krishkc5/agrasic/agriasic_digital_v2/docs/interface_contract.md

# AgriASIC Digital Interface Contract

Refreshed for Rev 4.2 + Rev 4.3 Phases 1-6. This document describes the
**currently implemented** RTL only. It covers the SPI/parallel-programming/
RV32I-MMIO *register* interfaces, none of which changed in Phase 7 or 8 —
the 3-frequency-point sweep that Phase 7 added lives entirely inside RV32I
*firmware* (`fw/fw.c`), not in any new register or protocol behavior, so
nothing below needed updating for it. What Phase 7 did surface is an
architectural gap in how that firmware's results reach a host at all — see
the "GAP-11" note under "What is not in this contract yet" below, and
[`agriasic_digital_MAS.md`](agriasic_digital_MAS.md) section 10.3 for full
detail. Temperature sensing (Phase 7.3) remains unbuilt in any digital RTL.

The previous version of this document predated three SPI behavior changes and
the whole Phase 1-3 restructure; do not write host firmware from an older
copy. It also predates Phase 4's excitation rearchitecture — the "phase
change" / "polarity register" language is gone, replaced by a free-running
phase counter (see "Analog front-end interface" below) — Phase 5's I/Q
accumulation, which turned every "the result" singular below into two
independent channels (see "Measurement control" and the register map) — and
Phase 6's full register-map renumbering (see the register map below; **every
address after 0x2 has moved or changed meaning** compared to any document
predating this one).

## Port naming convention

Every port on a boundary module (`agriasic_digital_rv32i_top`,
`agriasic_digital_spi_top`, `agriasic_digital_programming_top`,
`agriasic_digital_top`, `agriasic_rv32i_control_shell`) carries a prefix
saying where the signal goes:

| Prefix | Meaning |
|---|---|
| `afe_` | Crosses into the **analog front end**. Die-internal, unless the AFE is off-chip in a test configuration. |
| `gpio_` | Leaves the die — **bond these**. |
| `dbg_` | **Observability only. Do not bond.** Exposed so testbenches, the power flow and the memory audit can watch internal state without hierarchical references. |
| *(none)* | **Die-internal block-to-block wiring**, plus `clk` and `rst_n`. The two clock/reset pins are real pads, but "GPIO" implies a general-purpose bidirectional cell, which they are not. |

The prefix classifies a signal by **where it ends up**, not by which module
declares it. So a boundary module still has unprefixed ports where they simply
connect it to another block on the same die — `agriasic_rv32i_control_shell`
drives the measurement engine through `cfg_*_o` / `result_*_o` / `busy_o` /
`done_o`, and `agriasic_digital_top` receives them through `cfg_*_i` and
`start`. None of those reach a pad or the AFE, so none of them take a prefix.
The same signals *do* take `dbg_` where a chip top re-exports them purely for
observability.

Leaf modules (`sar_controller`, `excitation_ctrl`,
`measurement_fsm`, `spi_slave`, `regfile`, `agriasic_spi_boot`) deliberately
keep unprefixed local names — the prefix marks a chip boundary, and would
mean nothing three levels down. So `sar_controller.mux_sel_o` connects to
`agriasic_digital_top.afe_mux_sel_o`, and both names are correct.

## Clock and Reset
- `clk`: single digital clock domain for the entire design. As of Phase 3,
  there is no second clock domain anywhere in the synthesizable RTL — SPI's
  `sclk_i` is oversampled, not run as its own clock (see below).
- `rst_n`: active-low, asynchronous assert. Each chip-boundary top
  (`agriasic_digital_spi_top`, `agriasic_digital_programming_top`,
  `agriasic_digital_rv32i_top`) synchronizes it internally with a 2FF reset
  synchronizer (`rst_sync.sv`) before distributing it — synchronous
  deassert, so every internal flop sees a clean release edge regardless of
  when the external pin actually released.

## Measurement control
Names below are the measurement engine's (`agriasic_digital_top`). At a chip
top the same signals appear as `gpio_start_i` (in) and `dbg_busy_o` /
`dbg_done_o` / `dbg_result_*` (out).

- `start` / `gpio_start_i`: one-cycle pulse to begin one measurement run
- `busy_o`: high while the FSM is executing the run
- `done_o`: pulses high for one core cycle when the run completes (the SPI
  wrapper latches this into a sticky `REG_STATUS` bit — see below — because a
  host polling over SPI cannot reliably catch a single-cycle pulse)

  > **`dbg_done_o` at `agriasic_digital_rv32i_top` is a different signal with
  > the same name shape, and the pulse semantics above do NOT apply to it.**
  > The control shell assigns `done_o = fw_done`
  > (`agriasic_rv32i_control_shell.sv`): a **sticky level**, raised when the
  > firmware writes `CTRL.FW_DONE` after the last sweep point, cleared only by
  > a core reset via `run_clear_i`. It means *the whole sweep is finished and
  > the DMEM result block is stable*, not *one measurement completed*.
  > `dbg_busy_o` is likewise `!core_rst && !fw_done` — program running, not
  > engine running. Reading this section as written and building edge
  > detection for a host would be wrong twice over: the signal is a level,
  > and per the MAS prefix table a `dbg_` port is testbench observability and
  > **never reaches a pad**. See "Completion signalling" under the host SPI
  > port for what a host actually uses.
- `result_dv_i_o` / `result_dv_q_o` / `result_cur_i_o` / `result_cur_q_o`,
  all `[15:0]` (Rev 5; these replaced the Rev 4.3 `result_i_o`/`result_q_o`
  pair, which in turn replaced a single `result_o`): the voltage and current
  channel accumulators, in-phase and quadrature, each
  independently signed and valid once `done_o` has pulsed. Both are **shadow
  registers** — they latch the internal accumulators' final value only on
  measurement completion, so a read mid-run always returns the *previous*
  run's result, never a partial sum in progress (see the register map below
  for how these are exposed over each host interface)

## Host SPI port (closes GAP-11, `agriasic_digital_rv32i_top`)

Four pads, **separate from the flash port** because the two run opposite
directions on every wire. The chip is the slave.

| Pin | Dir | Meaning |
|---|---|---|
| `gpio_spi_sclk_i` | in | Host-driven clock, mode 0. **Max f_clk/16**, as for the SPI-host variant: oversampled, not a real clock. |
| `gpio_spi_cs_n_i` | in | Active low. One transaction per assertion; releasing it resets the framing. |
| `gpio_spi_mosi_i` | in | Command, address and write data. |
| `gpio_spi_miso_o` | out | Read data and status. |
| `gpio_spi_miso_oe_o` | out | Output enable; high only while selected. |

Protocol, one transaction per CS_N assertion:

| Phase | Bytes | Content |
|---|---|---|
| command | 1 | `0x03` READ, `0x02` WRITE, `0x05` RDSR |
| address | 4 | 32-bit, **big endian** (MSB first) |
| data | n x 4 | **little endian** within each word, address auto-increments by 4 |

`RDSR` returns one status byte: `[0]` busy, `[1]` sticky error. The sticky bit
clears at the **end** of the status transaction, so the byte the host reads
still carries it.

**Reach:** DMEM and the peripheral window only. IMEM and the debug module are
refused by the interconnect and raise the sticky error. Writes commit whole
32-bit words; a transaction cut short mid-word commits nothing.

### Completion signalling — the host polls (decided 2026-10-28)

**The chip never initiates.** There is no interrupt line, no attention pin and
no done pad. A host learns that a sweep has finished by polling, and that is a
decision rather than an omission: promoting `dbg_done_o` to a real pin was
considered and declined. It would have taken the digital side to 19 pads to
save traffic that measures, at a 0.5 ms poll interval over a 29 ms sweep,
about 139 µs of SPI time — roughly 0.5 % bus duty, against a core that is
parked in `wfi` for nearly all of it. Bandwidth was never the argument.

**Poll `STATUS[6]` (`fw_done`), not `RDSR`.** The `RDSR` byte carries `[0]`
bridge busy and `[1]` sticky error — the bridge's own state, nothing about the
measurement. `fw_done` lives only in the MMIO word at `0x8000_0014`, so the
poll is a `0x03` READ:

```
CS_N ↓
  0x03                    READ
  0x80 0x00 0x00 0x14     address, big endian
  0x00                    one dummy byte; STATUS[7:0] streams back
CS_N ↑
→ done when (byte & 0x40)
```

Six bytes, not nine: data is little endian within a word, so `STATUS[7:0]` —
and with it bit 6 — arrives first, and dropping `CS_N` early ends the
transaction cleanly because a read commits nothing. Reading `STATUS` has no
side effects (`fw_done_q` clears only on reset, `run_clear_i` or a `CTRL`
write, never on a read, unlike the `RDSR` sticky bit), so the poll is
idempotent.

**Do not poll `STATUS[0]`.** That is the engine's per-measurement busy, which
returns to idle 16 times during one 8-point sweep, so a host watching it can
declare victory on a half-written result block. Bit 6 is the only flag with
whole-sweep meaning.

This one deserves emphasis because it does **not** fail loudly. Scenario E
counts the polls that catch the engine idle mid-sweep and measured **0 of 90**
at a 0.5 ms interval: the gaps between measurements are microseconds wide
against a millisecond poll, so a host polling bit 0 passes on the bench and
then fails intermittently in the field, at a rate that depends on nothing but
poll phasing. A bit that is wrong 1 % of the time is harder to find than one
that is wrong always.

For the same reason, do not poll a DMEM word either — `OUT_NUM_POINTS`
is written last and is tempting, but DMEM is a latch array with undefined
power-up content, so no value distinguishes "not written yet".

**Why the flag can be trusted.** Every result store precedes the
`CTRL.FW_DONE` store in program order, and Ibex's LSU is strictly in-order
with one outstanding request — there is no store buffer that could let the
MMIO write retire ahead of the DMEM writes. Waiting for bit 6 is also what
prevents a **torn read**: the bus arbitrates per word, so a burst taken
mid-sweep can mix one point's `OUT_DV_I` with the previous sweep's
`OUT_DV_Q`. Nothing in the chip prevents that, by design — the host SPI port
is deliberately allowed to read DMEM while the core runs.

**Host-side timeout.** Size it for the worst configuration, not the measured
one. Sweep duration is
`cycles ≈ 16 · ΣN · measurements · (settle + 2·2^pair_log2)`, which is 4.68 M
cycles (29 ms at 160 MHz) at the firmware's defaults but 60.8 M (**380 ms**) at
`pair_log2 = 6`. `tb_agriasic_spi_host.sv` scenario E derives its bound from
this formula rather than hard-coding one, and runs exactly the poll sequence
above.

**Re-arming** is a `gpio_start_i` pulse: that resets the core, which clears
`fw_done` through `run_clear_i` in the same event, so there is no stale-done
race on a second sweep. A host cannot re-trigger the firmware over SPI — M4
is denied the debug module, and the firmware parks in `wfi` after one sweep.

---

## Analog front-end interface (Rev 4.3 Phases 1 and 4) — SUPERSEDED

> **Superseded by "Analog front-end interface (Rev 5, tetrapolar)" below.**
> Kept for the `adc_comp_i` convention and the SAR timing discussion, which
> still hold. Two things here are out of date: `exc_drive_p_o`/`exc_drive_n_o`
> no longer exist (Rev 5 replaced the square-wave pair with a sine DAC code),
> and every port named below now carries the `afe_` prefix at a boundary
> module — `adc_sample_o` is `afe_sample_o`, the rest are `afe_<name>`.

`adc_code_i` no longer exists anywhere in this design. The digital side now
runs the SAR bit-trial search itself:

| Port | Direction | Purpose |
|---|---|---|
| `exc_drive_p_o` | out | Positive excitation drive |
| `exc_drive_n_o` | out | Negative excitation drive |
| `adc_enable_o` | out | Analog core enable, asserted for the full conversion |
| `adc_sample_o` | out | Track-and-hold strobe, one cycle at conversion start |
| `adc_dac_o[7:0]` | out | Bit-trial DAC code, MSB-first successive approximation |
| `adc_comp_i` | in | Comparator decision (see convention below) |

**Excitation drive (Phase 4: free-running, no command input).** Excitation is
generated by a free-running divider and 4-bit phase counter — there is no
longer a "phase change" event to break before making: `exc_drive_p_o` and
`exc_drive_n_o` are pure combinational functions of the current phase value.
Phase encoding is 0-6 drive positive, 7 dead, 8-14 drive negative, 15 dead —
7 states per polarity half, exactly equal, with exactly one dead state
between every transition. `{exc_drive_p_o, exc_drive_n_o} = 2'b11` remains
structurally unreachable: the two drive signals are mutually exclusive
combinational ranges of the same phase counter, so no phase value can satisfy
both. The old `DEAD_CYCLES` RTL parameter is gone; dead time is now just
"one reserved phase state" (index 7 or 15), lasting exactly `N` clock cycles
(one phase state's duration) at both lines low before the next polarity
starts — and whether that is enough real dead time is still an open question
pending a number from analog (see the MAS, GAP-6).

Excitation frequency follows `f_exc = f_clk / (16 x N)`, verified exact (not
approximate) in simulation. As of Phase 6, N is set indirectly over SPI via
`REG_FREQ_SEL` (see the register map below), not written directly.

**`adc_comp_i` convention.** `1` = input ≥ current trial code (keep the bit,
it's a valid lower bound); `0` = input < current trial code (clear the bit,
it overshot). This is a **timed, unsynchronized** path — the controller
holds each trial code for at least `REG_CONV + 3` clk cycles before sampling the
decision (`S_TRIAL_SET`, `REG_CONV + 1` cycles of `S_TRIAL_WAIT`,
`S_TRIAL_EVAL`; see the register map). The code comes straight from a
register and changes once per trial, so it is glitch-free for that whole
window. Do not add a synchronizer to this signal; that would defeat the
point of a timed interface.

## SPI protocol
- Mode: SPI mode-0 (`CPOL=0`, `CPHA=0`)
- **Max SCLK = f_clk/16.** This is load-bearing, not a suggestion: `gpio_spi_sclk_i`,
  `gpio_spi_cs_n_i` and `gpio_spi_mosi_i` are 2FF-oversampled into the `clk` domain (Rev 4.3
  Phase 3), and the synchronizers need this much margin to resolve edges
  reliably. Exceeding it corrupts data — verified directly by
  `tb_spi_domain_crossing.sv`, which shows correct operation at exactly this
  rate and demonstrated corruption below the sampling clock's own Nyquist
  rate.
- `gpio_spi_miso_o` changes on a **synchronized** SCLK falling edge (an edge detected
  on the oversampled signal, not a real clock edge — there is no `gpio_spi_sclk_i`
  clock domain to speak of anymore)
- `gpio_spi_miso_oe_o`: high only while `gpio_spi_cs_n_i` is selected (synchronized), so
  pad-level logic can put `MISO` in high-Z otherwise. Combinationally derived
  from the synchronized `cs_n`, so it changes the same cycle selection does.
- Command byte format:
	- `bit[7]`: `1=READ`, `0=WRITE`
	- `bit[6:3]`: 4-bit register address
	- `bit[2:0]`: reserved, must be `3'b000`
- Every transaction is 2 bytes (`Byte0=command`, `Byte1=data/dummy`)
- If `Byte0` is illegal (reserved bits or bad address), the wrapper consumes
  `Byte1` and discards it to keep framing aligned
- **`gpio_spi_cs_n_i` deasserted mid-byte** resets only the SPI framing state (bit
  counter, TX shift register) — never any measurement state, which
  `spi_slave` has no access to in the first place. Reselecting starts a clean
  new byte; no chip reset is needed to recover from an aborted transaction.
- **No mandatory inter-byte gap.** An earlier revision of this document (and
  an earlier design revision) required leaving a gap of a few core clocks
  between bytes so a freshly decoded response byte had time to settle before
  being shifted out. As of Phase 3 this is no longer a separate requirement:
  the response byte is ready one `clk` cycle after the command byte
  completes, and at `f_clk/16` even a fully back-to-back byte leaves at least
  8 `clk` cycles of margin before the next possible falling edge. The
  `f_clk/16` rate limit already covers it.

The `spi_slave` leaf module inside `agriasic_digital_spi_top` keeps its own
unprefixed `sclk_i`/`cs_n_i`/`mosi_i`/`miso_o`/`miso_oe_o` port names; the
`gpio_spi_` names above are the chip pins those connect to.

## SPI response codes
- `0xA5`: write accepted (ACK)
- `0x5A`: write rejected (NACK, e.g. write to read-only register)
- `0xE1`: invalid command (`cmd[2:0] != 0`)
- `0xE2`: invalid register address

## Register map (as implemented, Rev 4.3 Phase 6)

This is now the Rev 4.3 **target** register layout, not an interim one — see
the two exceptions called out after the table.

| Addr | Name | Access | Purpose |
|---|---|---|---|
| `0x0` | `REG_CTRL` | RW | bit[0] write-one pulse to start measurement; bit[7] write-one clears sticky protocol error bits in `REG_STATUS[7:5]`. **No core-enable bit** — see the note below |
| `0x1` | `REG_PAIR_LOG2` | RW | Pair count as log2 (`M = 2^REG_PAIR_LOG2`). Values above 6 are clamped to 64 in hardware and set `REG_STATUS` bit[4] (overrange) |
| `0x2` | `REG_SETTLE` | RW | Excitation *periods* to wait after `start` before the FSM begins watching for a phase match (not raw clock cycles) |
| `0x3` | `REG_FREQ_SEL` | RW | **2-bit selector, not raw N**: `0` -> 10 MHz (N=1), `1` -> 100 kHz (N=100), `2` -> 1 kHz (N=10000). Replaces the Phase 1-5 `REG_DIVIDER` on *this* interface only. **It reaches 3 of the firmware's 8 sweep points and does not define the sweep** — see the note below |
| `0x4` | `REG_PHASE_IDX` | RW | Present in the map; writes are stored and read back, but **not wired to anything** — see the note below |
| `0x5` | `REG_CONV` | RW | Comparator regeneration wait, **in clk cycles, per SAR bit trial** — not total conversion latency. Total conversion time is `8 x (3 + REG_CONV)` clk cycles. Runtime-tunable because the real regeneration time isn't characterized yet |
| `0x6` | `REG_STATUS` | RO | bit[7] sticky protocol error; bit[6] sticky bad address; bit[5] sticky illegal write to RO register; bit[4] **overrange** (new); bit[1] done — **sticky**, latched when the FSM's one-cycle `done_o` fires, held until the next start; bit[0] busy |
| `0x7` | `REG_RESULT_IDX` | RW | Pointer into the result byte vector, 0-15. **Auto-increments only on a `REG_RESULT_DATA` read** — not on writes to this register, and not on reads of this register itself |
| `0x8` | `REG_RESULT_DATA` | RO | Byte at the current index — see the mapping below |
| `0x9` | `REG_ID` | RO | Fixed design/revision identifier, `0x43` |

**`REG_RESULT_DATA` index mapping.** This 16-byte indexed window belongs to
the legacy 2-byte SPI interface and was specified when the target was I/Q at
three frequency points plus temperature (13 bytes). **It is superseded for
sweep results**: the firmware now sweeps eight points with four results each
(dV I/Q and current I/Q) = 128 bytes, which this window cannot express. Read
sweep results from DMEM over the host SPI port or JTAG instead — the map is at
the end of this section. The window below remains accurate for what it is: a
single live I/Q pair from the measurement engine's shadow registers.

```text
idx 0: I low byte      idx 1: I high byte
idx 2: Q low byte      idx 3: Q high byte
idx 4-15: reserved, reads as 0x00 (future frequency points + temperature)
```

Read index 0-3 in order after setting `REG_RESULT_IDX = 0` to get a full I/Q
readout in 4 back-to-back reads with no further index writes needed — the
pointer auto-increments. Indices 4-15 read as a deliberate zero, not garbage:
no per-point result vector was ever built behind this window, and none will be
— the firmware's DMEM result block replaced the idea.

**Result semantics (Rev 4.3 defect fix D-3, unchanged since Phase 1):** each
channel is `sum(D+ - D-)` over M pairs — the **raw** accumulated difference,
with no per-pair scaling applied on die. Divide by M yourself, and by 2 again
for the true chop average: `I = (D(0°) - D(180°))/2`, `Q = (D(90°) -
D(270°))/2`. Both channels are **shadow registers**, not live accumulators —
they latch only when a run completes, so a host that reads mid-run (which it
should not do — check `busy_o`/`REG_STATUS` bit[0] first) gets the previous
run's complete result, never a partial sum.

**`REG_FREQ_SEL` — why a selector, and what it is NOT.** Read this before
assuming the chip only does three frequencies: **it does eight.** The sweep is
driven by firmware writing raw N to the MMIO `REG_DIVIDER` (14 bits, N =
1..16383, f_exc = 10 MHz / N), and `fw.c`'s `sweep_divider()` walks N = 1, 10,
32, 100, 316, 1000, 3162, 10000 — a half-decade log ladder from 10 MHz to
1 kHz. `REG_FREQ_SEL` is a convenience on the *legacy 2-byte SPI and parallel
programming* interfaces, which cannot carry 14 bits in one byte; it exposes
three of those eight N values as presets. Changing the sweep means editing
`sweep_divider()`, not this register.

The reason it is a selector at all: the internal divider is 14 bits (needs
N=10000 for the 1 kHz point) — too wide for a single SPI byte to carry, and
the 2-byte SPI protocol isn't being widened to fit it. A selector
is the only encoding that reaches 1 kHz through one SPI byte: the host writes
0/1/2, the wrapper looks up the matching N combinationally, and
`excitation_ctrl` never sees the difference. The parallel programming
interface uses the identical selector (`CFG_FREQ_SEL`) for the same reason.
**RV32I MMIO keeps a separate, differently-named register, `REG_DIVIDER`,
taking raw N directly** (word offset `0x8000_000C`) — native 32-bit MMIO
writes have no byte-framing constraint, so there was nothing to work around,
and giving it the same name as SPI's selector-based register would wrongly
suggest matching semantics.

**Two reserved items with no implemented semantics — `REG_PHASE_IDX` and
`REG_CTRL`'s core-enable bit.** Both are called for by the baseline design
doc's register map, and both accept writes and read them back, but do
nothing:
- `REG_PHASE_IDX` ("phase index into the 16-state counter") doesn't reconcile
  with how I/Q sampling actually works: `measurement_fsm` watches four FIXED,
  90-degree-spaced phase points, not one selectable one. A plausible reading
  — a phase offset shifting all four points together, as a calibration trim
  — is an interpretation, not a specification; building RTL against a guess
  for a silicon-bound register was judged worse than an honest no-op.
- `REG_CTRL`'s core-enable bit presumes a unified chip with a toggleable
  on-die RV32I core, which doesn't exist: the RV32I and SPI control paths are
  two separate, mutually exclusive top-level modules today
  (`agriasic_digital_rv32i_top` vs. `agriasic_digital_spi_top`).

Do not write host firmware that depends on either of these until the MAS's
GAP-10 is resolved with the people who specified them.

**Same result semantics, different mechanisms, on every host interface.** The
parallel programming interface (`agriasic_digital_programming_top`) exposes
both channels as bare `result_i_o`/`result_q_o` output ports — no index
scheme, since a direct hardware interface has no byte-framing reason to need
one. The RV32I MMIO interface exposes `REG_RESULT_I` at word offset
`0x8000_0018` and `REG_RESULT_Q` at `0x8000_001C` directly (see `fw/fw.c`).

## What is not in this contract yet
The register map above is the Rev 4.3 target layout as far as *mechanisms*
go. What's still missing is the *data* behind some of it:
- Real I/Q data for frequency points 2 and 3, and temperature, **on the SPI/
  parallel-programming/RV32I-MMIO register interfaces described above** —
  `REG_RESULT_DATA` indices 4-12 still read as zero on those interfaces. The
  3-frequency-point sweep itself now exists (Phase 7), but only as RV32I
  *firmware* logic (`fw/fw.c`) writing to its own scratch RAM, not as new
  register/protocol behavior on any of the interfaces this document covers
- `REG_PHASE_IDX` and `REG_CTRL`'s core-enable bit's actual semantics (see
  the notes above and MAS GAP-10)

**GAP-11 is resolved — sweep results ARE readable off chip.** This paragraph
previously said they were not; that predated the host SPI port.
`agriasic_digital_rv32i_top` now carries a host SPI slave port
(`agriasic_spi_host.sv`, bus master M4) that reaches DMEM and the peripheral
window with 32-bit accesses while the core runs, and the debug SBA reaches the
same memory over JTAG. Both paths are covered by the regression (stage 15
reads `OUT_COUNT`, `OUT_NUM_POINTS` and per-point results over SPI; stage 13
does the same over SBA).

### Sweep result map (DMEM, read over host SPI or JTAG SBA)

DMEM base is `0x0001_0000` and the result block starts at offset 0. Each array
is **8 words (0x20) wide** — one word per sweep point, indexed by point 0..7 in
the order `sweep_divider()` produces them (10 MHz first, 1 kHz last).

| Offset | Name | Words | Contents |
|---|---|---|---|
| `0x000` | `OUT_COUNT` | 1 | measurements averaged per point (2) |
| `0x004` | `OUT_NUM_POINTS` | 1 | points actually completed; **< 8 means the sweep was aborted** |
| `0x008` | `OUT_TEMP` | 1 | sentinel `-1`, not implemented (GAP-11 temperature half) |
| `0x00C` | reserved | 5 | reads undefined; do not rely on it |
| `0x020` | `OUT_DIV[8]` | 8 | divider N used at each point |
| `0x040` | `OUT_DV_I[8]` | 8 | dV in-phase average |
| `0x060` | `OUT_DV_Q[8]` | 8 | dV quadrature average |
| `0x080` | `OUT_CUR_I[8]` | 8 | current in-phase average |
| `0x0A0` | `OUT_CUR_Q[8]` | 8 | current quadrature average |
| `0x0C0` | `OUT_AFE[8]` | 8 | `AFE_CTRL` value and overrange flags per point |
| `0x0E0` | — | 28 | guard, then the stack grows down from `0x180` |

Read `OUT_NUM_POINTS` first and trust only that many entries of each array: an
aborted sweep leaves the remaining entries holding the previous run's values,
not zeros. Results are valid once `STATUS.FW_DONE` is set; the same raw
accumulator semantics apply as above (divide by `OUT_COUNT`, and by 2 again
for the true chop average).

The map lives in one place, the header comment of `fw/fw.c`. If these offsets
and that comment ever disagree, the firmware is right and this table is stale.

---

## JTAG debug port (Phase 2, `agriasic_digital_rv32i_top` only)

Five pins, IEEE 1149.1, into the RISC-V debug module (pulp `riscv-dbg`,
Debug Spec 0.13) inside the control shell. Present only on the RV32I chip
variant; `agriasic_digital_spi_top` is unchanged.

| Pin | Dir | Notes |
|---|---|---|
| `gpio_jtag_tck_i` | in | Test clock. Keep well below the core clock (the DTM crosses TCK -> clk with a 2-phase handshake); 1 MHz is safe for any core clock above ~10 MHz. |
| `gpio_jtag_tms_i` | in | Test mode select. Five cycles high resets the TAP without TRST. |
| `gpio_jtag_trst_ni` | in | Asynchronous TAP reset, active low. Independent of `rst_n`, so a debugger can stay attached across a chip reset. Tie high if unused. |
| `gpio_jtag_tdi_i` | in | Data in, sampled on rising TCK. |
| `gpio_jtag_tdo_o` | out | Data out, launched on falling TCK. Not tri-stated (single device on the chain). |

IDCODE `0x14341001` (version 1, part `0x4341`). IR length 5: `0x01` IDCODE,
`0x10` DTMCS, `0x11` DMI (abits = 7). DM base `0x1A11_0000`; halt / resume /
exception entries at `+0x800 / +0x808 / +0x810`.

Debugger-visible address map: IMEM `0x0000_0000` (1 KiB, writable: `load`
works), DMEM `0x0001_0000` (384 B, 96 words), DM `0x1A11_0000`, MMIO `0x8000_0000`
(register map in section 7.1 / `agriasic_rv32i_mmio.sv`). Any other address
is a bus error. `dmcontrol.ndmreset` resets the core and the MMIO bridge
(config registers, sticky flags) but not IMEM, the DM or the TAP.

The hart is held in reset and reported `unavailable` to the debugger while
`gpio_start_i` is low. `fw/openocd_agriasic.cfg` is the reference OpenOCD target
file.

---

## SPI-flash boot port (Phase 3, `agriasic_digital_rv32i_top` only)

| Pin | Dir | Notes |
|---|---|---|
| `gpio_boot_sel_i` | in | Strap, sampled once on the first cycle out of reset. **0 (default): shadow-load the on-die golden boot ROM into IMEM** -- no flash needed. 1: load from external SPI flash instead. `BOOT_CTRL` overrides either way. |
| `gpio_flash_sck_o` | out | SPI mode 0 clock, clk/16 during boot (10 MHz at 160 MHz); firmware-selectable afterwards. |
| `gpio_flash_cs_n_o` | out | Active-low chip select. |
| `gpio_flash_mosi_o` | out | Master out. |
| `gpio_flash_miso_i` | in | Master in. |
| `gpio_boot_fail_o` | out | High when the boot FSM ended in FAIL (also `BOOT_STATUS[10]`). |

Flash image at address 0, little-endian words: `0x41475241` ("AGRA"),
payload length (bytes, multiple of 4, <= 4096), version, CRC-32 (zlib) of the
payload; then the payload. Produced by `fw/build.sh` as
`agriasic_fw_flash.bin`. Only `READ 0x03` is used; any 3-byte-address SPI NOR
works. The loader waits `BOOT_DELAY_CYCLES` (default 800k = 5 ms) after reset
for the flash's power-up time.

Registers (data-port / SBA window `0x8000_0020..0x8000_003F`):

| Address | Name | Access | Bits |
|---|---|---|---|
| `0x8000_0020` | `BOOT_STATUS` | R | [3:0] state (7 DONE, 8 FAIL, 9 SKIP, 10 ROM copy), [6:4] error (1 magic, 2 length, 3 CRC, 4 bus; a ROM boot can only report 4), [8] fw_valid, [9] latched strap, [10] boot_fail, [11] busy, [13:12] source (0 none/skip, 1 golden ROM, 2 flash), [31:16] image version (flash header; 0 for a ROM boot) |
| `0x8000_0024` | `BOOT_CTRL` | W | [0] release core, [1] re-boot from flash, [2] re-boot from the golden ROM (each drops fw_valid first: core reset, then reboot) |
| `0x8000_0028` | `SPI_CTRL` | RW | [0] cs_n, [15:8] clock divider (SCK = clk / 2(div+1)) |
| `0x8000_002C` | `SPI_DATA` | RW | W: byte to send (starts a transfer); R: last byte received |
| `0x8000_0030` | `SPI_STATUS` | R | [0] busy, [1] firmware owns the SPI pins (boot FSM idle) |

---

## Analog front-end interface (Rev 5, tetrapolar)

Digital-to-analog signals. The first seven are present on all three chip tops
(`agriasic_digital_rv32i_top`, `agriasic_digital_spi_top`,
`agriasic_digital_programming_top`). **`afe_tia_rf_o` is RV32I-only** --- the
legacy 2-byte SPI and parallel-programming register maps have no `AFE_CTRL`
register to set it from, so on those variants the TIA gain is not controllable
at all. These are die-internal to the AFE, not pads, except where the AFE is
off-chip in a test configuration.

| Signal | Dir | Meaning |
|---|---|---|
| `afe_sine_code_o[7:0]` | out | Sine DAC code, offset binary, mid-code 128 = VCM (0.9 V). 16-point cosine, one code per phase state. Registered and glitch-free: changes only on a phase step, or one cycle after the excitation is enabled, disabled or its amplitude changes. |
| `afe_mux_sel_o[1:0]` | out | Analog mux: 0 = dV (differential PGA on E2/E3), 1 = return current (TIA on E4). Stable for the whole conversion. |
| `afe_sample_o` | out | Track-and-hold strobe. Fires ONCE per phase point and freezes **both** channels' S/H simultaneously. |
| `afe_adc_enable_o` | out | High for the duration of each conversion (comparator bias/power gate). |
| `afe_adc_dac_o[7:0]` | out | SAR trial code to the ADC's internal DAC. Registered: changes once per trial and is then stable for at least `REG_CONV + 3` clk cycles. |
| `afe_adc_comp_i` | in | One comparator decision: 1 = input >= trial code. Timed, unsynchronized — `REG_CONV` must cover regeneration at the worst corner. |
| `afe_conv_start_o` | out | One-cycle pulse marking the start of each conversion, issued **after** the `mux_settle` wait rather than at request acceptance, so it lands once the mux and S/H have settled onto the ADC input. One per conversion, so two per `afe_sample_o` strobe. |
| `afe_tia_rf_o[2:0]` | out | TIA feedback resistor: **three switch wires**, same decode. **RV32I top only** --- see the note above. |

**The differential PGA has a FIXED gain** and no digital control. In a
voltage-driven tetrapolar measurement dV is a fixed fraction of the drive set by
electrode geometry, so that channel has little dynamic range; the current channel
carries it. `AFE_CTRL[1:0]` is reserved, reads 0.

**Gain encoding.** The TIA control is a 2-bit code in `AFE_CTRL` decoded to three
switch wires by `gain_decode` in `agriasic_rv32i_mmio.sv`, so the analog side
needs no decoder and illegal switch combinations are unreachable. The register
reads back the **code**, not the wires. Current mapping, *pending analog
confirmation* -- that function is the only place to change it:

| Code | Wires | Meaning |
|---|---|---|
| 0 | `001` | switch 0 alone |
| 1 | `010` | switch 1 alone |
| 2 | `100` | switch 2 alone |
| 3 | `111` | all three in parallel |

No code leaves a network fully open. That is deliberate: for the TIA an open
feedback network has no DC path and the output rails, and the reset code is 0,
so an encoding where 0 meant "all switches open" would make railing the
power-on condition.

Per sample point the sequence is: strobe both S/H at the target phase ->
`mux_sel = 0`, wait `AFE_CTRL.mux_settle`, 8 bit trials -> `mux_sel = 1`,
wait, 8 bit trials. Four phase points (0/90/180/270 deg) make one
accumulation pair, so a pair is eight conversions.

Accumulators (all signed 16-bit, host-visible only via the shadow snapshot
taken when `busy` falls):

    dv_i  = sum( dV(0deg)  - dV(180deg) )      cur_i = sum( I(0deg)  - I(180deg) )
    dv_q  = sum( dV(90deg) - dV(270deg) )      cur_q = sum( I(90deg) - I(270deg) )

Impedance is computed off-die: Z(f) = (dv_i + j*dv_q) / (cur_i + j*cur_q).

**Simultaneous sample-and-hold is confirmed, not an assumption.** This
paragraph previously listed it as an open analog decision. The ADC progress
report of 2026-10-26 (Q4) states that two matched S/H schematics share
sampling phases and capture together, which is what the RTL has always
assumed; skew and mismatch between them are characterized but not yet
verified over corners. The alternative that was under consideration —
measuring dV on one excitation period and I on the next — is dropped: it
needs one fewer S/H but doubles the measurement time and assumes
stationarity across adjacent periods.

**The SAR bit trials stay in digital.** Confirmed with the ADC owner on
2026-10-27. The behavioural model shipped alongside that report
(`agrasic_adc_behavioral.sv`, a complete converter with an
`enable`/`capture`/`start`/`code`/`done` interface) is a **simulation aid
only** and is not the integration contract — its own README says it "does
not replace the final SAR controller." The boundary is therefore the one
in the table above and nowhere else: digital drives `afe_adc_dac_o` and reads
one `afe_adc_comp_i` decision per trial, and no `afe_adc_code_i` or
`afe_adc_done_i` port is being added. Two items on the analog side are still
open and would each cost a handful of gates if they land on digital: a
per-trial DAC / reference-switch enable, because the report's Q7 measures
settling from reference-switch enable rather than from the code edge, and the
binary-to-one-hot mux decode that its Q3 calls "external".

The golden ROM image is generated from `fw/golden/agriasic_fw_golden.hex` by
`fw/gen_boot_rom.py` into `rtl/rv32i/agriasic_boot_rom.sv`. It is frozen at
tapeout; the flash path is how a newer image is run. Both load into the same
IMEM SRAM at address 0, so firmware is linked once for both.
