krishkc5/agrasic/agriasic_digital_v2/docs/agriasic_highlevel.jpeg

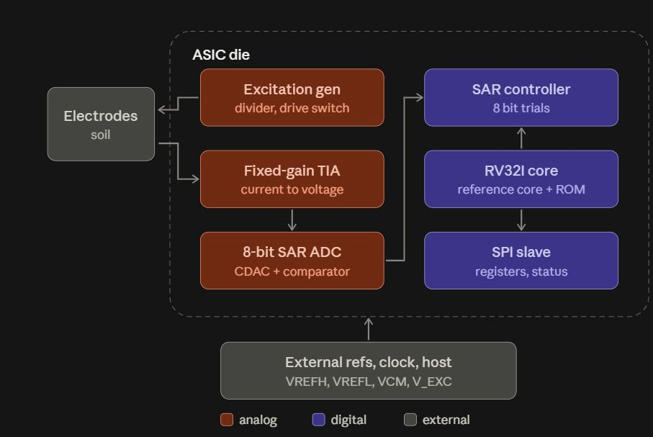
agriasic_digital_v2/docs/agriasic_highlevel.jpeg
