krishkc5/agrasic/agriasic_digital_v2/power/results/power_summary.pdf

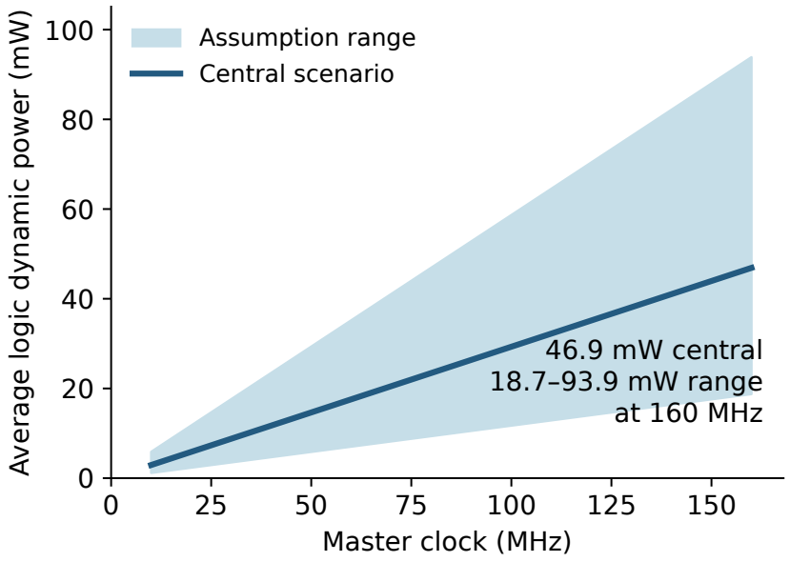
[picture p4: figure]
Master clock (MHz); Average logic dynamic power (mW); 46.9 mW central 18.7–93.9 mW range at 160 MHz; Assumption range Central scenario

0.0 | 2.5 | 5.0 | 7.5 | 10.0 12.5 15.0 17.5
Clock-related dynamic power (mW)

CPU pipeline

Register file

Mul/div

Measurement

Shell / MMIO / bus

Debug module

Boot loader

11.64

12.86

0.97

1.87

1.14

13.94

4.43

2,800 synthesized register bits
25 fF effective clock load per bit (assumed)

### Central assumption at 160 MHz

### Same firmware sweep, scaled clock

## AgriASIC digital power budget | 1.8 V

RTL activity + generic synthesis + assumed capacitances. Excludes memory macros, leakage and pads. 160 MHz is a target, not timing-verified. Range is a sensitivity study, not a confidence interval.
