krishkc5/agrasic/agriasic_digital_v2/memory/results/accesses.csv

cycle | after_ecall | kind | address | byte_mask
7 | 0 | fetch | 00000080 | f
8 | 0 | fetch | 00000084 | f
9 | 0 | fetch | 00000088 | f
10 | 0 | retire | 00000080 | f
10 | 0 | fetch | 0000008c | f
11 | 0 | retire | 00000084 | f
11 | 0 | fetch | 00000090 | f
11 | 0 | sp | 00010000 | 0
28 | 0 | sp | 00000000 | 0
30 | 0 | fetch | 00000080 | f
31 | 0 | fetch | 00000084 | f
32 | 0 | fetch | 00000088 | f
33 | 0 | retire | 00000080 | f
33 | 0 | fetch | 0000008c | f
34 | 0 | retire | 00000084 | f
34 | 0 | fetch | 00000090 | f
34 | 0 | sp | 00010000 | 0
35 | 0 | retire | 00000088 | f
35 | 0 | fetch | 00000094 | f
35 | 0 | sp | 00010200 | 0
36 | 0 | retire | 0000008a | f
38 | 0 | fetch | 00000148 | f
39 | 0 | retire | 0000008e | f
39 | 0 | fetch | 0000014c | f
40 | 0 | fetch | 00000150 | f
41 | 0 | retire | 00000148 | f
41 | 0 | fetch | 00000154 | f
41 | 0 | store | 000101fc | f
42 | 0 | retire | 0000014a | f
42 | 0 | store | 000101f8 | f
42 | 0 | sp | 000101e0 | 0
43 | 0 | retire | 0000014c | f
43 | 0 | fetch | 00000158 | f
43 | 0 | store | 000101f4 | f
44 | 0 | retire | 0000014e | f
44 | 0 | fetch | 0000015c | f
45 | 0 | retire | 00000150 | f
45 | 0 | fetch | 00000160 | f
46 | 0 | retire | 00000154 | f
46 | 0 | store | 80000000 | f
47 | 0 | retire | 00000158 | f
47 | 0 | fetch | 00000164 | f
48 | 0 | retire | 0000015a | f
48 | 0 | store | 80000004 | f
49 | 0 | retire | 0000015c | f
49 | 0 | fetch | 00000168 | f
50 | 0 | retire | 0000015e | f
50 | 0 | fetch | 0000016c | f
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
3155064 | 1 | retire | 0000009c | f
3155064 | 1 | fetch | 000000a8 | f
3155068 | 1 | fetch | 0000009c | f
3155069 | 1 | retire | 000000a0 | f
3155069 | 1 | fetch | 000000a0 | f
3155070 | 1 | fetch | 000000a4 | f
3155071 | 1 | retire | 0000009c | f
3155071 | 1 | fetch | 000000a8 | f
