krishkc5/agrasic/agriasic_digital_v2/power/results/activity.csv

row | cycles | imem_ce | ram_ce | periph_writes | adc_samples | adc_on | exc_on | done | pc_bit_toggles | divider_bit_toggles | core_enabled | core_reset
0 | 296 | 104 | 16 | 9 | 0 | 0 | 4 | 0 | 213 | 305 | 296 | 0
1 | 2778 | 0 | 0 | 0 | 32 | 2240 | 2764 | 2 | 3 | 0 | 0 | 10
2 | 259 | 76 | 14 | 3 | 0 | 0 | 4 | 0 | 168 | 304 | 259 | 0
3 | 31350 | 0 | 0 | 0 | 32 | 2240 | 31348 | 2 | 0 | 0 | 0 | 0
4 | 273 | 85 | 19 | 3 | 0 | 0 | 4 | 0 | 182 | 304 | 273 | 0
5 | 3120150 | 0 | 0 | 0 | 32 | 2240 | 3120148 | 2 | 0 | 0 | 0 | 0
6 | 4102 | 2344 | 0 | 0 | 0 | 0 | 0 | 0 | 5860 | 0 | 4102 | 0
7 | 4096 | 1 | 0 | 0 | 0 | 0 | 0 | 0 | 3 | 11 | 1 | 4095
