krishkc5/agrasic/agriasic_digital_v2/power/results/epochs.csv

time_ps | cycle | epoch | divider
10 | 1 | 2 | 0
70 | 7 | 1 | 0
220 | 12 | 2 | 0
280 | 18 | 1 | 0
680 | 58 | 2 | 1
14510 | 1441 | 1 | 1
14730 | 1463 | 2 | 1
28560 | 2846 | 1 | 1
30630 | 3053 | 2 | 100
187380 | 18728 | 1 | 100
187600 | 18750 | 2 | 100
344350 | 34425 | 1 | 100
346440 | 34634 | 2 | 10000
15947190 | 1594709 | 1 | 10000
15947410 | 1594731 | 2 | 10000
31548160 | 3154806 | 1 | 10000
31550340 | 3155024 | 3 | 10000
31591360 | 3159126 | 4 | 10000
