krishkc5/agrasic/agriasic_digital_v2/power/results/register_activity.csv

epoch | block | register_bits | bit_toggles | rising_transitions
1 | boot_loader | 347 | 35 | 16
1 | core_divider | 75 | 1056 | 533
1 | core_pipeline | 898 | 18094 | 9073
1 | core_register_file | 992 | 539 | 285
1 | debug_module | 1076 | 229 | 119
1 | measurement_engine | 235 | 99 | 18
1 | shell_mmio_reset | 103 | 730 | 370
2 | boot_loader | 347 | 12 | 10
2 | core_divider | 75 | 0 | 0
2 | core_pipeline | 898 | 2 | 2
2 | core_register_file | 992 | 0 | 0
2 | debug_module | 1076 | 32 | 26
2 | measurement_engine | 235 | 6330742 | 3165426
2 | shell_mmio_reset | 103 | 20 | 12
3 | boot_loader | 347 | 0 | 0
3 | core_divider | 75 | 0 | 0
3 | core_pipeline | 898 | 112510 | 56268
3 | core_register_file | 992 | 0 | 0
3 | debug_module | 1076 | 2344 | 1172
3 | measurement_engine | 235 | 0 | 0
3 | shell_mmio_reset | 103 | 2345 | 1172
4 | boot_loader | 347 | 0 | 0
4 | core_divider | 75 | 10 | 0
4 | core_pipeline | 898 | 53 | 20
4 | core_register_file | 992 | 31 | 0
4 | debug_module | 1076 | 2 | 1
4 | measurement_engine | 235 | 0 | 0
4 | shell_mmio_reset | 103 | 4 | 1
