krishkc5/agrasic/agriasic_digital_v2/power/results/power_summary.png

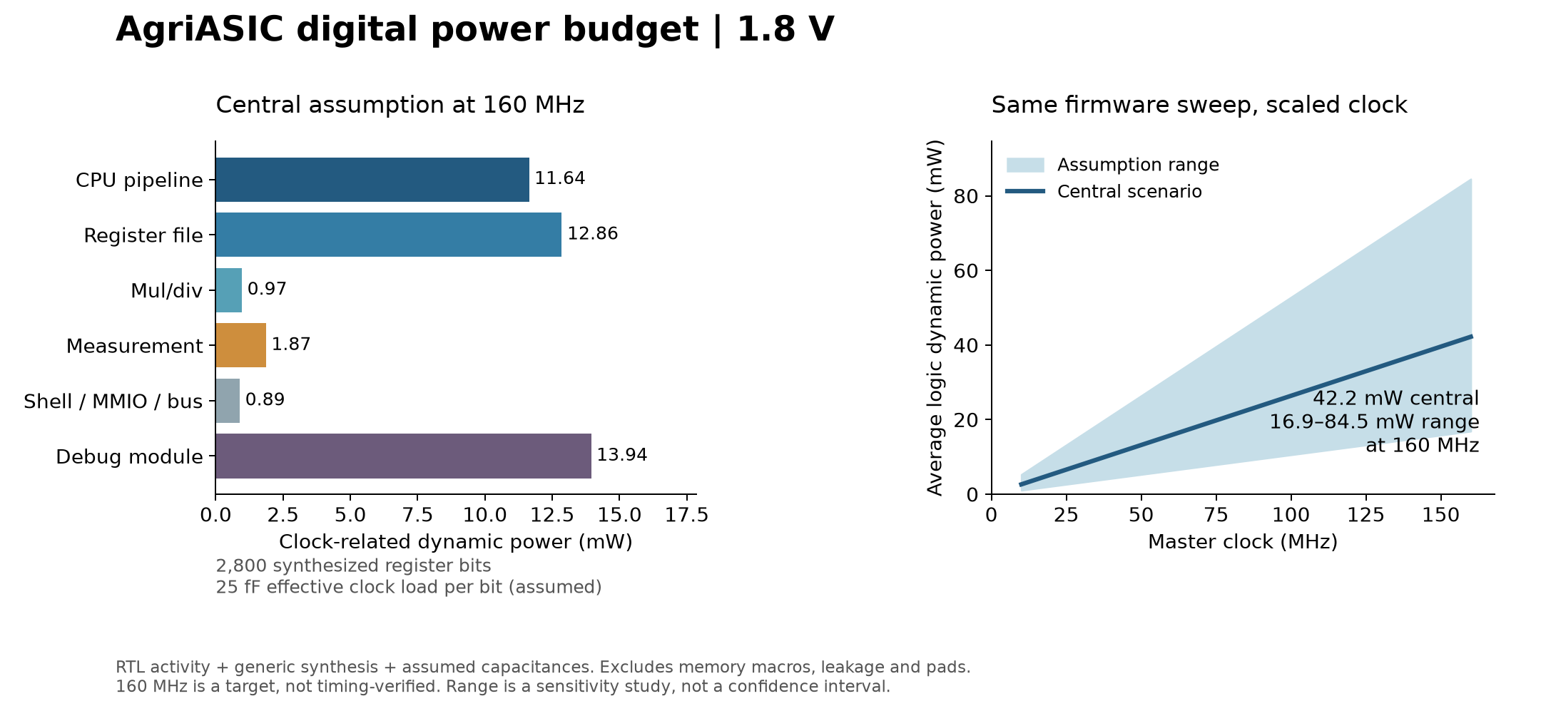
agriasic_digital_v2/power/results/power_summary.png
