krishkc5/agrasic/agriasic_digital_v2/rtl/ctrl/sar_controller.sv

// -----------------------------------------------------------------------------
// Module: sar_controller
// Purpose:
//   Runs the successive-approximation bit-trial search and bridges the result
//   to digital measurement sequencing.
//
// Rev 4.3 change -- bit trials moved into digital:
//   The earlier version received a finished code on adc_code_i from a
//   self-contained converter. Rev 4.3 replaces that with the real SAR
//   interface: this controller drives the trial DAC code on adc_dac_o and
//   reads one comparator decision at a time on adc_comp_i, MSB first, exactly
//   as a real successive-approximation ADC is sequenced.
//
// adc_comp_i convention (drive the analog testbench/model to this contract):
//   1 = input >= current trial code   (keep this bit set, current code stays
//       a valid lower bound, move to the next bit)
//   0 = input <  current trial code   (clear this bit, it overshot)
//   adc_comp_i is NOT synchronized -- it is a timed path. This controller
//   guarantees comparator regeneration time (conv_cycles_i cycles) between
//   presenting a trial code and sampling the decision; it is the caller's
//   responsibility that conv_cycles_i covers the real regeneration time.
//
// conv_cycles_i meaning changed with the interface:
//   Previously "total cycles before reading one finished code." Now it is the
//   regeneration wait PER BIT TRIAL (8 trials per sample; each trial costs
//   conv_cycles_i + 3 cycles -- SET, WAIT, EVAL -- so total conversion time is
//   8 * (3 + conv_cycles_i) cycles). Making this a runtime register
//   rather than a fixed parameter is deliberate: comparator regeneration time
//   depends on process corner and is not yet characterized (MAS GAP-2) --
//   REG_CONV lets it be tuned during bring-up without a respin.
//
// Functionality:
//   - Accepts one sample request at a time.
//   - Asserts conv_start_o for one cycle when the mux/S-H settling wait
//     expires, immediately before the first bit trial -- NOT at acceptance.
//     The analog behavioural model treats its start input as the instant the
//     selected channel is latched, so a pulse at acceptance would mark a
//     value the mux has not settled onto yet.
//   - Asserts adc_enable_o for the full conversion (accept through done).
//   - Drives mux_sel_o from channel_i and waits mux_settle_cycles_i before the
//     first bit trial, so the analog mux and the selected sample-and-hold have
//     settled onto the ADC input.
//   - Runs 8 bit trials MSB first, each gated by conv_cycles_i regeneration
//     cycles, to build the digitized code entirely from adc_comp_i decisions.
//   - Drives adc_dac_o straight from a register that changes once per trial
//     (at acceptance for the first trial, otherwise on the S_TRIAL_EVAL ->
//     S_TRIAL_SET edge) and then holds through S_TRIAL_WAIT and S_TRIAL_EVAL.
//     A trial code therefore stands for at least conv_cycles_i + 3 cycles
//     before its decision is sampled, and nothing moves on the CDAC while the
//     comparator is resolving. (It used to be decoded from state_q, whose
//     WAIT -> EVAL step, 3'b011 -> 3'b100, flips every state bit at once and
//     could briefly drop the bit under test at the start of EVAL -- the last
//     cycle before the decision is taken.) Chip-level STA times the DAC ->
//     comparator -> flop loop as a multicycle path on the strength of this
//     (asic-top design/chip_afe.sdc).
//   - Presents the converged code on code_o with sample_done_o.
//
// Rev 5 change -- two channels, one converter:
//   The tetrapolar front end has two signal chains (differential voltage from
//   the PGA on E2/E3, current from the TIA on E4) sharing one differential SAR
//   ADC through an analog mux. Two things follow.
//
//   1. take_sample_i separates ACQUISITION from CONVERSION. Both channels'
//      sample-and-holds are strobed together by a single adc_sample_o pulse
//      (take_sample_i = 1) at the phase instant the measurement FSM chooses;
//      the second conversion of the pair then runs with take_sample_i = 0 and
//      digitises the value already held. That is what preserves the voltage /
//      current phase relationship: both channels are frozen at the same
//      instant, and only the digitising is sequential.
//
//   2. The converged codes are no longer stored here. With two channels and a
//      +/- chop there are four codes per accumulation pair, and which one is
//      which is the FSM's sequencing knowledge, not the converter's. This
//      module now returns one code per conversion on code_o and the FSM owns
//      the routing. (The old d_plus_o/d_minus_o pair is gone.)
//
// mux_settle_cycles_i, like conv_cycles_i, is a runtime register rather than a
// parameter: the mux + S/H settling time depends on process corner and load
// and is not characterized yet.
// -----------------------------------------------------------------------------
module sar_controller #(
  parameter int unsigned ADC_WIDTH = 8
) (
  input  logic                 clk,
  input  logic                 rst_n,
  input  logic                 sample_req_i,
  input  logic                 take_sample_i,   // 1: strobe the S/H, 0: convert the held value
  // Abort: drop the conversion in flight and return to S_IDLE. Without this a
  // conversion aborted by measurement_fsm would still run to completion and
  // pulse sample_done_o, which the next run could mistake for its own.
  input  logic                 abort_i,
  input  logic [1:0]           channel_i,       // analog mux select for this conversion
  input  logic [7:0]           conv_cycles_i,
  input  logic [7:0]           mux_settle_cycles_i,
  output logic                 conv_start_o,
  output logic                 sample_done_o,
  output logic                 busy_o,
  output logic [ADC_WIDTH-1:0] code_o,          // converged code for this conversion
  // Rails on the converged code. A successive-approximation search that ends
  // at all-zeros or all-ones did not actually bracket the input -- it ran out
  // of range. Valid with sample_done_o. The gain controls exist to fix this,
  // so firmware needs to be told it happened.
  output logic                 overrange_o,
  output logic [1:0]           mux_sel_o,

  // Rev 4.3 SAR bit-trial interface. adc_comp_i is a timed, unsynchronized
  // path -- see the header note on the regeneration-time contract.
  output logic                 adc_enable_o,
  output logic                 adc_sample_o,
  output logic [ADC_WIDTH-1:0] adc_dac_o,
  input  logic                 adc_comp_i
);

  localparam int unsigned BIT_IDX_W = (ADC_WIDTH <= 1) ? 1 : $clog2(ADC_WIDTH);

  typedef enum logic [2:0] {
    S_IDLE,
    S_MUX_WAIT,    // analog mux + S/H settling before the first trial
    S_TRIAL_SET,   // present the trial code, load the regeneration counter
    S_TRIAL_WAIT,  // wait out comparator regeneration time
    S_TRIAL_EVAL   // sample adc_comp_i, decide the bit, advance or finish
  } state_t;

  state_t                     state_q;
  logic [BIT_IDX_W-1:0]       bit_idx_q;
  logic [ADC_WIDTH-1:0]       dac_reg_q;   // decided bits only (0 below/at bit_idx_q until resolved)
  logic [7:0]                 regen_cnt_q;

  // Trial mask for the bit currently under test, and the code that would
  // result from EITHER decision -- computed combinationally so the last bit's
  // decision can be captured the same cycle it is made, with no one-cycle lag
  // between the register update and the value presented on code_o.
  logic [ADC_WIDTH-1:0] trial_mask;
  logic [ADC_WIDTH-1:0] eval_code;
  assign trial_mask = ({{(ADC_WIDTH-1){1'b0}}, 1'b1} << bit_idx_q);
  assign eval_code  = adc_comp_i ? (dac_reg_q | trial_mask) : dac_reg_q;

  // adc_dac_o presents the trial code (decided bits plus the bit under test)
  // for every state past acceptance; at idle it holds the last converged code,
  // a deterministic and harmless value since adc_enable_o is low. It is a
  // register, loaded wherever dac_reg_q / bit_idx_q / state_q are, with the
  // value those are about to take -- so it shows each code in the same cycle
  // the old combinational decode did, with no extra latency, and only a flop
  // between it and the pin. See the header bullet for why.
  localparam logic [ADC_WIDTH-1:0] MSB_MASK = {1'b1, {(ADC_WIDTH-1){1'b0}}};

  always_ff @(posedge clk or negedge rst_n) begin
    if (!rst_n) begin
      state_q       <= S_IDLE;
      conv_start_o  <= 1'b0;
      adc_sample_o  <= 1'b0;
      adc_enable_o  <= 1'b0;
      sample_done_o <= 1'b0;
      busy_o        <= 1'b0;
      bit_idx_q     <= '1;
      dac_reg_q     <= '0;
      adc_dac_o     <= '0;
      regen_cnt_q   <= 8'd0;
      code_o        <= '0;
      overrange_o   <= 1'b0;
      mux_sel_o     <= 2'd0;
    end else begin
      conv_start_o  <= 1'b0;
      adc_sample_o  <= 1'b0;
      sample_done_o <= 1'b0;

      if (abort_i) begin
        // Stated in full rather than leaning on the defaults above: an abort
        // block is the one place where the complete effect should be readable
        // without looking elsewhere. Leaving mux_sel_o and the S/H wherever
        // they are is harmless -- the next conversion re-drives the mux and
        // re-strobes the hold before trial 1.
        state_q       <= S_IDLE;
        adc_dac_o     <= dac_reg_q;   // the idle value
        busy_o        <= 1'b0;
        adc_enable_o  <= 1'b0;
        conv_start_o  <= 1'b0;
        adc_sample_o  <= 1'b0;
        sample_done_o <= 1'b0;
      end else
      unique case (state_q)
        S_IDLE: begin
          // Do not accept a new request in the same cycle a completion is
          // being reported. The measurement FSM holds sample_req_i high until
          // it observes sample_done_o, so without this guard the controller
          // would immediately launch a second, spurious conversion the cycle
          // after finishing -- sampling after the excitation polarity may
          // already have moved on, corrupting d_plus/d_minus.
          if (sample_req_i && !sample_done_o) begin
            busy_o       <= 1'b1;
            adc_enable_o <= 1'b1;
            // Track-and-hold strobe only on the first conversion of a pair:
            // it freezes BOTH channels at this instant. The second conversion
            // digitises the already-held value (take_sample_i = 0).
            adc_sample_o <= take_sample_i;
            mux_sel_o    <= channel_i;
            bit_idx_q    <= BIT_IDX_W'(ADC_WIDTH - 1);
            dac_reg_q    <= '0;
            adc_dac_o    <= MSB_MASK;   // first trial: no bits decided, MSB under test
            regen_cnt_q  <= mux_settle_cycles_i;
            state_q      <= S_MUX_WAIT;
          end
        end

        S_MUX_WAIT: begin
          // mux_sel_o is already driven; give the mux and the selected S/H
          // time to settle onto the comparator input before the first trial.
          if (regen_cnt_q == 8'd0) begin
            // The conversion proper begins HERE, not at acceptance: the mux
            // and the selected sample-and-hold have settled onto the ADC
            // input and the first trial follows next cycle. Still a one-cycle
            // pulse (the default assignment above clears it) and still
            // exactly one per accepted request -- only its position moved.
            conv_start_o <= 1'b1;
            state_q      <= S_TRIAL_SET;
          end else begin
            regen_cnt_q <= regen_cnt_q - 8'd1;
          end
        end

        S_TRIAL_SET: begin
          // adc_dac_o already presents this trial (it was loaded on the edge
          // into this state); this state just loads the regeneration wait.
          regen_cnt_q <= conv_cycles_i;
          state_q     <= S_TRIAL_WAIT;
        end

        S_TRIAL_WAIT: begin
          if (regen_cnt_q == 8'd0) begin
            state_q <= S_TRIAL_EVAL;
          end else begin
            regen_cnt_q <= regen_cnt_q - 8'd1;
          end
        end

        S_TRIAL_EVAL: begin
          dac_reg_q <= eval_code;
          if (bit_idx_q == '0) begin
            // Last bit decided: eval_code is the converged result.
            adc_dac_o     <= eval_code;   // the idle value
            code_o        <= eval_code;
            overrange_o   <= (eval_code == '0) || (&eval_code);
            busy_o        <= 1'b0;
            adc_enable_o  <= 1'b0;
            sample_done_o <= 1'b1;
            state_q       <= S_IDLE;
          end else begin
            bit_idx_q <= bit_idx_q - 1'b1;
            // next trial: this decision folded in, the next bit down under test
            adc_dac_o <= eval_code | (trial_mask >> 1);
            state_q   <= S_TRIAL_SET;
          end
        end

        default: begin
          state_q   <= S_IDLE;
          adc_dac_o <= dac_reg_q;   // the idle value
        end
      endcase
    end
  end

`ifndef SYNTHESIS
  // adc_dac_o must show exactly what the combinational decode it replaced
  // would have, every cycle: the registered version is meant to change WHEN
  // the code is driven (only a flop in front of the pin), never WHAT it is.
  always_ff @(posedge clk) begin
    if (rst_n)
      assert (adc_dac_o == ((state_q == S_IDLE) ? dac_reg_q : (dac_reg_q | trial_mask)))
        else $error("sar_controller: adc_dac_o 0x%02h, expected trial code 0x%02h (state %0d)",
                    adc_dac_o, (state_q == S_IDLE) ? dac_reg_q : (dac_reg_q | trial_mask),
                    state_q);
  end
`endif

endmodule
