krishkc5/agrasic/agriasic_digital_v2/rtl/agriasic_digital_programming_top.sv

// -----------------------------------------------------------------------------
// Module: agriasic_digital_programming_top
// Purpose:
//   Programming-oriented wrapper for the optional RV32I controller
//   architecture. This wrapper keeps the measurement FSM as the real-time
//   engine and exposes a compact programming surface for firmware-driven setup.
//
// Notes:
//   - This is a control/programming layer, not the timing-critical measurement
//     engine itself.
//   - The wrapper keeps the same measurement core used by the SPI top-level.
//   - A future RV32I core with ROM can drive the program/write inputs directly.
// -----------------------------------------------------------------------------
module agriasic_digital_programming_top #(
  parameter int unsigned ADC_WIDTH = 8
) (
  input  logic                 clk,
  input  logic                 rst_n,

  // Compact programming interface intended for an RV32I firmware controller.
  input  logic                 prog_cfg_we_i,
  input  logic [1:0]           prog_cfg_addr_i,
  input  logic [7:0]           prog_cfg_data_i,
  input  logic                 prog_start_i,

  output logic                 conv_start_o,
  output logic                 exc_drive_p_o,
  output logic                 exc_drive_n_o,
  output logic                 adc_enable_o,
  output logic                 adc_sample_o,
  output logic [ADC_WIDTH-1:0] adc_dac_o,
  input  logic                 adc_comp_i,
  output logic                 busy_o,
  output logic                 done_o,
  output logic [15:0]          result_o,

  // Expose the active programming state for debug and bring-up.
  output logic [3:0]           cfg_pair_log2_o,
  output logic [7:0]           cfg_settle_cycles_o,
  output logic [13:0]          cfg_exc_divider_o,  // Rev 4.3 Phase 4.2: widened 8->14 bits, see GAP-1
  output logic [7:0]           cfg_conv_cycles_o
);

  // Rev 4.3 Phase 2.1: rst_n is the raw, possibly-asynchronous chip pin.
  // Everything internal runs off rst_n_sync, released synchronously to clk.
  logic rst_n_sync;
  rst_sync u_rst_sync (
    .clk     (clk),
    .rst_n_i (rst_n),
    .rst_n_o (rst_n_sync)
  );

  logic       start_pulse_q;
  logic       prog_start_q;
  logic [3:0]  cfg_pair_log2_q;
  logic [7:0]  cfg_settle_q;
  // Rev 4.3 Phase 4.2: internal datapath widened to 14 bits (GAP-1); the
  // 8-bit prog_cfg_data_i write path zero-extends into it for now, same
  // interim scoping as REG_DIVIDER in agriasic_digital_spi_top.sv.
  logic [13:0] cfg_divider_q;
  logic [7:0]  cfg_conv_q;

  localparam logic [1:0] CFG_PAIR_LOG2 = 2'd0;
  localparam logic [1:0] CFG_SETTLE    = 2'd1;
  localparam logic [1:0] CFG_DIVIDER   = 2'd2;
  localparam logic [1:0] CFG_CONV      = 2'd3;

  assign cfg_pair_log2_o     = cfg_pair_log2_q;
  assign cfg_settle_cycles_o = cfg_settle_q;
  assign cfg_exc_divider_o   = cfg_divider_q;
  assign cfg_conv_cycles_o   = cfg_conv_q;

  agriasic_digital_top #(
    .ADC_WIDTH(ADC_WIDTH)
  ) u_core (
    .clk                (clk),
    .rst_n              (rst_n_sync),
    .start              (start_pulse_q),
    .cfg_pair_log2_i    (cfg_pair_log2_q),
    .cfg_settle_cycles_i(cfg_settle_q),
    .cfg_exc_divider_i  (cfg_divider_q),
    .cfg_conv_cycles_i  (cfg_conv_q),
    .conv_start_o       (conv_start_o),
    .exc_drive_p_o      (exc_drive_p_o),
    .exc_drive_n_o      (exc_drive_n_o),
    .adc_enable_o       (adc_enable_o),
    .adc_sample_o       (adc_sample_o),
    .adc_dac_o          (adc_dac_o),
    .adc_comp_i         (adc_comp_i),
    .busy_o             (busy_o),
    .done_o             (done_o),
    .result_o           (result_o)
  );

  always_ff @(posedge clk or negedge rst_n_sync) begin
    if (!rst_n_sync) begin
      start_pulse_q   <= 1'b0;
      prog_start_q    <= 1'b0;
      cfg_pair_log2_q <= 4'd2;
      cfg_settle_q    <= 8'd2;
      cfg_divider_q   <= 14'd0;
      cfg_conv_q      <= 8'd1;
    end else begin
      start_pulse_q <= prog_start_i & ~prog_start_q;
      prog_start_q  <= prog_start_i;

      if (prog_cfg_we_i) begin
        unique case (prog_cfg_addr_i)
          CFG_PAIR_LOG2: cfg_pair_log2_q <= prog_cfg_data_i[3:0];
          CFG_SETTLE:    cfg_settle_q    <= prog_cfg_data_i;
          CFG_DIVIDER:   cfg_divider_q   <= {6'd0, prog_cfg_data_i};  // zero-extend
          CFG_CONV:      cfg_conv_q      <= prog_cfg_data_i;
          default: begin
          end
        endcase
      end
    end
  end

endmodule
