krishkc5/agrasic/agriasic_digital_v2/rtl/rv32i/agriasic_rv32i_mmio.sv

// -----------------------------------------------------------------------------
// Module: agriasic_rv32i_mmio
// Purpose:
//   Data-side bus for the Ibex control core. Decodes the core's OBI-style data
//   port into scratch RAM and a memory-mapped peripheral window that drives
//   the measurement engine.
//
//   Ibex replaces the Penn CIS 5710 core (previous bridge preserved as
//   agriasic_rv32i_mmio.sv.penn). Two things changed at this boundary:
//     1. The port is the Ibex/OBI request-grant-rvalid handshake instead of a
//        raw SRAM strobe. Grant is combinational (always ready), rvalid is the
//        registered request: the same 1-cycle contract the SRAM wrapper and
//        the previous bridge already implemented.
//     2. The decode is now FULL. Previously only addr[31] and addr[4:2] were
//        looked at, so any address outside the two windows silently aliased.
//        Now anything outside RAM or the peripheral window returns data_err,
//        which Ibex turns into a load/store access-fault trap. An out-of-map
//        store is a visible fault in silicon, not a silent write to nowhere.
//
// Memory map (data side; Phase 2 flat map, see agriasic_rv32i_bus.sv):
//   RAM_BASE .. RAM_BASE+RAM_BYTES-1 : scratch RAM (stack / working data),
//                                      RAM_BASE = 0x0001_0000 in the shell
//   0x8000_0000 - 0x8000_003F        : peripheral window (two 32-byte halves)
//   everything else                  : bus error (data_err_o)
//
//   The bridge sits behind agriasic_rv32i_bus, which arbitrates the core's
//   data port and the debug module's system-bus master onto this one port.
//
// Peripheral registers (word aligned, selected by addr[5:2] -- 16 words, not the
// 8 the pre-fix decode could reach; see note 2 above):
//   0x8000_0000  CTRL       W   bit0 = start (REJECTED while busy -- abort first),
//                                bit1 = abort (force the engine back to idle;
//                                       wins over bit0 in the same write)
//                                bit7 = clear sticky errors
//                                bit8 = FW_DONE   (sticky; firmware finished,
//                                                  replaces the old ecall halt)
//                                bit9 = TRAP_SEEN (sticky; written by the trap
//                                                  handler so a fault is visible)
//   0x8000_0004  PAIR_LOG2  RW  [3:0]
//   0x8000_0008  SETTLE     RW  [7:0]
//   0x8000_000C  DIVIDER    RW  [13:0] raw N (see the Rev 4.3 Phase 4.2/6 note
//                                       in the MAS on why MMIO and SPI differ)
//   0x8000_0010  CONV       RW  [7:0]
//   0x8000_0014  STATUS     R   bit0 = busy, bit1 = done,
//                                bit2 = ADC overrange on dV, bit3 = on current,
//                                bit4 = pair-count guard (NOT an ADC rail),
//                                bit5 = trap_seen, bit6 = fw_done,
//                                bit7 = start rejected (START written while
//                                       busy), sticky, cleared by CTRL bit7
//                                bit8 = ABORTED (sticky; the run was cut short
//                                       by CTRL.abort, so NO fresh result was
//                                       produced -- the shadows still hold the
//                                       previous one). Cleared by CTRL bit7 or
//                                       by the next accepted start.
//   0x8000_0018  RESULT_I   R   [15:0] signed dV in-phase accumulator
//   0x8000_001C  RESULT_Q   R   [15:0] signed dV quadrature accumulator
//
// Rev 5 -- tetrapolar front end. RESULT_I/RESULT_Q now carry the DIFFERENTIAL
// VOLTAGE channel (PGA on E2/E3); the return-current channel (TIA on E4) is a
// second complex pair, and a host computes Z(f) = dV(f) / I(f):
//   0x8000_0034  RESULT_CUR_I R  [15:0] signed current in-phase accumulator
//   0x8000_0038  RESULT_CUR_Q R  [15:0] signed current quadrature accumulator
//   0x8000_003C  AFE_CTRL    RW  [1:0]  RESERVED, reads 0. Was pga_gain; the
//                                       voltage sense has a FIXED gain, so the
//                                       field went with the wires rather than
//                                       being left inert.
//                                [3:2]  tia_rf     2-bit code -> 3 switch wires
//                                       (see gain_decode below; the register
//                                        reads back the code, not the wires)
//                                [5:4]  amplitude  (sine excursion: full/half/quarter/eighth)
//                                [15:8] mux_settle_cycles (analog mux + S/H settling)
//
// Boot / SPI-master registers (Phase 3, implemented in agriasic_spi_boot;
// this bridge only decodes them and forwards the strobes):
//   0x8000_0020  BOOT_STATUS R   state, error, fw_valid, boot_sel, boot_fail, version
//   0x8000_0024  BOOT_CTRL   W   bit0 = release core, bit1 = re-boot from flash,
//                                bit2 = re-boot from the golden ROM
//   0x8000_0028  SPI_CTRL    RW  bit0 = cs_n, [15:8] = clock divider
//   0x8000_002C  SPI_DATA    RW  W: byte to send (starts transfer); R: last byte received
//   0x8000_0030  SPI_STATUS  R   bit0 = busy, bit1 = firmware owns the SPI pins
//
// Sleep / wake:
//   meas_wake_irq_o is the core's wake source: sticky DONE *or* sticky
//   ABORTED. Both have to wake the core -- an abort produces no done, so
//   waking only on done would leave firmware asleep forever after a host
//   abort. They stay SEPARATE status bits so that "woken" never implies "a
//   fresh result is ready": firmware checks ABORTED before reading results.
//   Exported so the shell can feed it to Ibex's irq_fast_i[0].
//   Firmware writes START, executes wfi, and
//   Ibex wakes when DONE goes pending (mie.fast0 set, mstatus.MIE clear, so
//   no trap is taken -- execution simply resumes after the wfi). The next
//   START clears the latch. This replaces the previous shell's core_clk_en.
//
// Timing contract:
//   Peripheral reads are registered so the window presents the SAME 1-cycle
//   read latency as the SRAM macro; rvalid is asserted one cycle after req
//   for both slaves and for errors.
//
// Pulse generation:
//   A store to CTRL asserts data_we for exactly one cycle (OBI: one request
//   per transfer), so a registered decode of that write yields the
//   single-cycle start pulse the measurement FSM requires.
// -----------------------------------------------------------------------------
module agriasic_rv32i_mmio #(
  parameter int unsigned RAM_WORDS = 1024,
  parameter logic [31:0] RAM_BASE  = 32'h0001_0000
) (
  input  logic        clk,
  input  logic        rst_n,
  // Clears the firmware-owned sticky bits (FW_DONE, TRAP_SEEN) whenever the
  // core is put back into reset by the shell, so a new run starts clean.
  input  logic        run_clear_i,

  // Data-side port from Ibex (OBI-style).
  input  logic        data_req_i,
  output logic        data_gnt_o,
  output logic        data_rvalid_o,
  input  logic        data_we_i,
  input  logic [3:0]  data_be_i,
  input  logic [31:0] data_addr_i,   // word aligned by the Ibex LSU
  input  logic [31:0] data_wdata_i,
  output logic [31:0] data_rdata_o,
  output logic        data_err_o,

  // Control outputs to the measurement engine.
  output logic        start_pulse_o,
  output logic        abort_pulse_o,    // CTRL.abort, single cycle
  output logic        clear_errors_o,
  output logic [3:0]  cfg_pair_log2_o,
  output logic [7:0]  cfg_settle_cycles_o,
  output logic [13:0] cfg_exc_divider_o,
  output logic [7:0]  cfg_conv_cycles_o,
  // Rev 5 analog front-end configuration.
  output logic [7:0]  cfg_mux_settle_o,
  output logic [1:0]  cfg_amplitude_o,
  input  logic        overrange_dv_i,   // ADC rails on the dV channel
  input  logic        overrange_cur_i,  // ADC rails on the current channel
  output logic [2:0]  cfg_tia_rf_o,     // 3 switch wires, decoded below

  // Firmware-state outputs to the shell.
  output logic        fw_done_o,        // firmware wrote CTRL.FW_DONE
  output logic        trap_seen_o,      // firmware wrote CTRL.TRAP_SEEN
  output logic        meas_wake_irq_o,  // sticky DONE or ABORTED, level interrupt

  // Status inputs from the measurement engine.
  //   done_i is the FSM's RAW single-cycle done pulse.
  input  logic        done_i,
  input  logic signed [15:0] result_dv_i_i,
  input  logic signed [15:0] result_dv_q_i,
  input  logic signed [15:0] result_cur_i_i,
  input  logic signed [15:0] result_cur_q_i,

  // Boot / SPI-master register plumbing to agriasic_spi_boot.
  output logic        boot_release_o,     // pulse
  output logic        boot_retry_o,       // pulse: re-boot from flash
  output logic        boot_rom_o,         // pulse: re-boot from the golden ROM
  output logic        spi_ctrl_we_o,      // pulse
  output logic [15:0] spi_ctrl_wdata_o,
  output logic        spi_data_we_o,      // pulse
  output logic [7:0]  spi_data_wdata_o,
  input  logic [31:0] boot_status_i,
  input  logic [31:0] spi_ctrl_i,
  input  logic [7:0]  spi_rx_i,
  input  logic [31:0] spi_status_i
);

  localparam int unsigned RAM_BYTES  = RAM_WORDS * 4;

  localparam logic [3:0] REG_CTRL        = 4'd0;
  localparam logic [3:0] REG_PAIR_LOG2   = 4'd1;
  localparam logic [3:0] REG_SETTLE      = 4'd2;
  localparam logic [3:0] REG_DIVIDER     = 4'd3;
  localparam logic [3:0] REG_CONV        = 4'd4;
  localparam logic [3:0] REG_STATUS      = 4'd5;
  localparam logic [3:0] REG_RESULT_I    = 4'd6;
  localparam logic [3:0] REG_RESULT_Q    = 4'd7;
  localparam logic [3:0] REG_BOOT_STATUS = 4'd8;
  localparam logic [3:0] REG_BOOT_CTRL   = 4'd9;
  localparam logic [3:0] REG_SPI_CTRL    = 4'd10;
  localparam logic [3:0] REG_SPI_DATA    = 4'd11;
  localparam logic [3:0] REG_SPI_STATUS  = 4'd12;
  localparam logic [3:0] REG_RESULT_CUR_I = 4'd13;
  localparam logic [3:0] REG_RESULT_CUR_Q = 4'd14;
  localparam logic [3:0] REG_AFE_CTRL     = 4'd15;

  localparam logic [31:0] PERIPH_BASE  = 32'h8000_0000;
  localparam logic [31:0] PERIPH_MASK  = 32'hFFFF_FFC0;   // 64-byte window

  // --------------------------------------------------------------------------
  // Address decode (full)
  // --------------------------------------------------------------------------
  wire        ram_sel    = (data_addr_i >= RAM_BASE) && (data_addr_i < RAM_BASE + RAM_BYTES);
  // agriasic_dmem indexes by the low address bits, so it sees the offset
  // within the RAM window regardless of where the window is based.
  wire [31:0] ram_addr   = data_addr_i - RAM_BASE;
  wire        periph_sel = ((data_addr_i & PERIPH_MASK) == PERIPH_BASE);
  wire        unmapped   = !ram_sel && !periph_sel;
  wire [3:0]  periph_reg = data_addr_i[5:2];

  wire        periph_wr  = data_req_i && periph_sel &&  data_we_i && data_be_i[0];
  wire        periph_rd  = data_req_i && periph_sel && !data_we_i;
  wire        ram_ce     = data_req_i && ram_sel;
  wire [3:0]  ram_we     = data_we_i ? data_be_i : 4'b0000;

  // Always ready: both slaves complete every transfer in exactly one cycle.
  assign data_gnt_o = data_req_i;

  // --------------------------------------------------------------------------
  // Scratch RAM
  // --------------------------------------------------------------------------
  logic [31:0] ram_dout;

  agriasic_dmem #(
    .NUM_WORDS(RAM_WORDS)
  ) u_dmem (
    .clk    (clk),
    .rst_n  (rst_n),
    .ce_i   (ram_ce),
    .we_i   (ram_we),
    .addr_i (ram_addr),
    .din_i  (data_wdata_i),
    .dout_o (ram_dout)
  );

  // --------------------------------------------------------------------------
  // Configuration registers
  //
  // Reset values match the defaults the original control shell applied, so
  // the measurement engine behaves identically out of reset with no firmware.
  // --------------------------------------------------------------------------
  logic [3:0]  cfg_pair_log2_q;
  logic [7:0]  cfg_settle_q;
  logic [13:0] cfg_divider_q;
  logic [7:0]  cfg_conv_q;
  logic [7:0]  cfg_mux_settle_q;
  logic [1:0]  cfg_amplitude_q;
  logic [1:0]  cfg_tia_rf_q;
  logic        fw_done_q;
  logic        trap_seen_q;

  assign cfg_pair_log2_o     = cfg_pair_log2_q;
  assign cfg_settle_cycles_o = cfg_settle_q;
  assign cfg_exc_divider_o   = cfg_divider_q;
  assign cfg_conv_cycles_o   = cfg_conv_q;
  assign cfg_mux_settle_o    = cfg_mux_settle_q;
  assign cfg_amplitude_o     = cfg_amplitude_q;
  // ---------------------------------------------------------------------------
  // Analog gain decode: a 2-bit register code becomes 3 switch wires
  //
  // The analog side takes three wires per gain control and closes switches
  // directly, with no decoder of its own. The REGISTER stays 2 bits so the
  // firmware and host interface remains a compact code and AFE_CTRL reads back
  // what was written; the decode lives here, at the boundary, which also makes
  // illegal switch combinations structurally unreachable rather than merely
  // discouraged.
  //
  // >>> ENCODING NOT YET CONFIRMED BY ANALOG. This table is the single place to
  // change it, and nothing outside this function depends on the mapping. <<<
  //
  // The default deliberately has NO all-open state. For a transimpedance amp an
  // open feedback network leaves no DC path and the output rails, and the reset
  // code is 0 -- so an encoding where code 0 means "all switches open" would
  // make railing the power-on condition. Every code below closes at least one
  // switch:
  //
  //   code 0 -> 3'b001   switch 0 alone
  //   code 1 -> 3'b010   switch 1 alone
  //   code 2 -> 3'b100   switch 2 alone
  //   code 3 -> 3'b111   all three in parallel
  //
  // That also gives the documented 10k / 100k / 1M a sensible fourth state (the
  // three in parallel) rather than leaving one code undefined. If analog wants
  // thermometer coding instead (001 / 011 / 111), change the four returns here
  // and nothing else moves.
  // ---------------------------------------------------------------------------
  function automatic logic [2:0] gain_decode(input logic [1:0] code);
    unique case (code)
      2'd0: return 3'b001;
      2'd1: return 3'b010;
      2'd2: return 3'b100;
      2'd3: return 3'b111;
    endcase
  endfunction

  assign cfg_tia_rf_o        = gain_decode(cfg_tia_rf_q);
  assign fw_done_o           = fw_done_q;
  assign trap_seen_o         = trap_seen_q;

  always_ff @(posedge clk or negedge rst_n) begin
    if (!rst_n) begin
      cfg_pair_log2_q <= 4'd2;
      cfg_settle_q    <= 8'd2;
      cfg_divider_q   <= 14'd0;
      cfg_conv_q      <= 8'd1;
      // Rev 5 defaults: 2 cycles of mux/S-H settling, full sine amplitude,
      // lowest PGA gain and lowest TIA transimpedance -- the safe corner for
      // bring-up, raised by firmware once signal levels are known.
      cfg_mux_settle_q <= 8'd2;
      cfg_amplitude_q  <= 2'd0;
      cfg_tia_rf_q     <= 2'd0;
      start_pulse_o   <= 1'b0;
      abort_pulse_o   <= 1'b0;
      clear_errors_o  <= 1'b0;
      fw_done_q       <= 1'b0;
      trap_seen_q     <= 1'b0;
    end else begin
      // Default low: both are single-cycle pulses.
      start_pulse_o  <= 1'b0;
      abort_pulse_o  <= 1'b0;
      clear_errors_o <= 1'b0;

      if (run_clear_i) begin
        fw_done_q   <= 1'b0;
        trap_seen_q <= 1'b0;
      end

      if (periph_wr) begin
        unique case (periph_reg)
          REG_CTRL: begin
            // Starting while busy is not allowed: the sequencer only samples
            // start in S_IDLE, so such a write used to vanish with no way for
            // firmware to know. It is now rejected explicitly and flagged in
            // STATUS[7]. To restart early, write CTRL.abort then CTRL.start.
            //
            // Abort wins over start in the same write. Without the !abort term
            // the two disagreed: the busy register below takes the abort branch
            // and leaves busy clear, while the sequencer -- which only honours
            // abort outside S_IDLE -- would accept the start. The engine would
            // run with STATUS reporting idle. The dropped start is flagged in
            // STATUS[7] rather than lost silently.
            start_pulse_o  <= data_wdata_i[0] && !data_wdata_i[1] && !meas_busy_q;
            abort_pulse_o  <= data_wdata_i[1];
            clear_errors_o <= data_wdata_i[7];
            if (data_be_i[1]) begin
              if (data_wdata_i[8]) fw_done_q   <= 1'b1;
              if (data_wdata_i[9]) trap_seen_q <= 1'b1;
            end
          end
          REG_PAIR_LOG2: cfg_pair_log2_q <= data_wdata_i[3:0];
          REG_SETTLE:    cfg_settle_q    <= data_wdata_i[7:0];
          REG_DIVIDER:   cfg_divider_q   <= data_wdata_i[13:0];
          REG_CONV:      cfg_conv_q      <= data_wdata_i[7:0];
          REG_AFE_CTRL: begin
            // [1:0] reserved: the voltage sense gain is fixed in analog.
            cfg_tia_rf_q     <= data_wdata_i[3:2];
            cfg_amplitude_q  <= data_wdata_i[5:4];
            if (data_be_i[1]) cfg_mux_settle_q <= data_wdata_i[15:8];
          end
          // STATUS / RESULT / BOOT_STATUS / SPI_STATUS are read-only; the
          // boot and SPI registers live in agriasic_spi_boot (strobes below).
          default: begin
          end
        endcase
      end
    end
  end

  // Boot / SPI-master write strobes: one-cycle pulses, data forwarded as-is.
  always_ff @(posedge clk or negedge rst_n) begin
    if (!rst_n) begin
      boot_release_o   <= 1'b0;
      boot_retry_o     <= 1'b0;
      boot_rom_o       <= 1'b0;
      spi_ctrl_we_o    <= 1'b0;
      spi_ctrl_wdata_o <= 16'd0;
      spi_data_we_o    <= 1'b0;
      spi_data_wdata_o <= 8'd0;
    end else begin
      boot_release_o <= periph_wr && (periph_reg == REG_BOOT_CTRL) && data_wdata_i[0];
      boot_retry_o   <= periph_wr && (periph_reg == REG_BOOT_CTRL) && data_wdata_i[1];
      boot_rom_o     <= periph_wr && (periph_reg == REG_BOOT_CTRL) && data_wdata_i[2];
      spi_ctrl_we_o  <= periph_wr && (periph_reg == REG_SPI_CTRL);
      spi_data_we_o  <= periph_wr && (periph_reg == REG_SPI_DATA);
      if (periph_wr) begin
        spi_ctrl_wdata_o <= data_wdata_i[15:0];
        spi_data_wdata_o <= data_wdata_i[7:0];
      end
    end
  end

  // --------------------------------------------------------------------------
  // Measurement status latches
  //
  // busy MUST set in the same cycle the CTRL start write is registered: the
  // firmware fallback path (poll STATUS after START) reads it the very next
  // cycle. done is latched sticky because the FSM's done_o is a single-cycle
  // pulse, and it doubles as the level-sensitive wake interrupt for wfi.
  // --------------------------------------------------------------------------
  wire ctrl_start_write = periph_wr && (periph_reg == REG_CTRL) && data_wdata_i[0];
  wire ctrl_abort_write = periph_wr && (periph_reg == REG_CTRL) && data_wdata_i[1];
  // A start write that was NOT honoured, for either reason: the engine was
  // busy, or the same write also asserted abort, which wins.
  wire start_rejected_w = ctrl_start_write && (meas_busy_q || ctrl_abort_write);

  logic meas_busy_q;
  logic meas_done_q;

  always_ff @(posedge clk or negedge rst_n) begin
    if (!rst_n) begin
      meas_busy_q <= 1'b0;
      meas_done_q <= 1'b0;
    end else if (ctrl_abort_write) begin
      // An aborted run produces no done pulse, so busy must be cleared here or
      // STATUS would read busy forever and every later start would be rejected.
      meas_busy_q <= 1'b0;
    end else if (ctrl_start_write && !meas_busy_q) begin
      meas_busy_q <= 1'b1;
      meas_done_q <= 1'b0;
    end else if (done_i) begin
      meas_busy_q <= 1'b0;
      meas_done_q <= 1'b1;
    end
  end

  // Sticky: the run was cut short by an abort, so no fresh result exists.
  // This is what keeps "the core woke up" from meaning "a result is ready":
  // it wakes the core (below) but is reported separately from done.
  logic meas_aborted_q;
  always_ff @(posedge clk or negedge rst_n) begin
    if (!rst_n)                                 meas_aborted_q <= 1'b0;
    else if (ctrl_abort_write)                  meas_aborted_q <= 1'b1;
    else if (ctrl_start_write && !meas_busy_q)  meas_aborted_q <= 1'b0;
    else if (clear_errors_o)                    meas_aborted_q <= 1'b0;
  end

  // Sticky: a start that arrived while busy was discarded. Cleared by
  // CTRL.clear_err, like the other sticky error bits.
  logic start_rejected_q;
  always_ff @(posedge clk or negedge rst_n) begin
    if (!rst_n)                 start_rejected_q <= 1'b0;
    else if (start_rejected_w)  start_rejected_q <= 1'b1;
    else if (clear_errors_o)    start_rejected_q <= 1'b0;
  end

  // Wake on either. Done alone would strand firmware in wfi after an abort:
  // an aborted run emits no done pulse, by design, so there would be nothing
  // left to wake it and the sweep would hang half-finished.
  //
  // BOTH sources are gated on the core not having parked for good. start.S
  // ends in `park: wfi; j park`, this wake is LEVEL sensitive, and both sticky
  // bits can still be set when the core arrives there -- so an ungated term
  // holds the line high with nothing left to clear it (firmware has already
  // run its clear path for the last time), wfi returns immediately forever,
  // and the core spins at full clock instead of sleeping. A wake only ever
  // needs to reach a core that is WAITING for a measurement; once firmware has
  // finished or trapped, waking it just re-parks it.
  //
  // DONE is the term that bites on the NORMAL path, and it was missed when
  // this gate was first added. The firmware's closing CTRL.CLEAR_ERR drops
  // ABORTED, but nothing clears meas_done_q except a reset or an accepted
  // start -- so after a SUCCESSFUL sweep the final measurement's DONE was
  // still set at the park. Measured on the e2e bench before this fix:
  // meas_wake_irq=1, core_sleep high 0 cycles out of 2000, instr_req busy
  // 1143 of them, i.e. the park loop fetching flat out for the rest of the
  // chip's life. The aborted path was safe only incidentally, because an abort
  // deliberately emits no done pulse; that is why tb_abort_wake's park checks
  // passed while the completed-sweep park had never been looked at.
  //
  // Gating cannot mask a wake the firmware needs. fw_done_q is set only after
  // main() returns and trap_seen_q only in the trap handler, and both of those
  // paths park forever without waiting on a measurement again. run_clear_i (a
  // core reset via gpio_start_i) and ndmreset clear both, so a restarted
  // firmware wakes normally.
  assign meas_wake_irq_o = (meas_done_q || meas_aborted_q) &&
                           !fw_done_q && !trap_seen_q;

  // --------------------------------------------------------------------------
  // Peripheral read path (registered: same 1-cycle latency as the SRAM)
  // --------------------------------------------------------------------------
  wire status_overrange_w = (cfg_pair_log2_q > 4'd6);

  logic [31:0] periph_rdata;
  always_comb begin
    unique case (periph_reg)
      REG_PAIR_LOG2: periph_rdata = {28'd0, cfg_pair_log2_q};
      REG_SETTLE:    periph_rdata = {24'd0, cfg_settle_q};
      REG_DIVIDER:   periph_rdata = {18'd0, cfg_divider_q};
      REG_CONV:      periph_rdata = {24'd0, cfg_conv_q};
      // [3:2] are the real ADC overrange bits, one per channel, held by the
      // measurement FSM until the next run starts. Bit 4 is a different
      // thing despite the name: a static guard on the configured pair count.
      REG_STATUS:    periph_rdata = {23'd0, meas_aborted_q, start_rejected_q,
                                     fw_done_q, trap_seen_q, status_overrange_w,
                                     overrange_cur_i, overrange_dv_i,
                                     meas_done_q, meas_busy_q};
      REG_RESULT_I:  periph_rdata = {{16{result_dv_i_i[15]}}, result_dv_i_i};
      REG_RESULT_Q:  periph_rdata = {{16{result_dv_q_i[15]}}, result_dv_q_i};
      REG_RESULT_CUR_I: periph_rdata = {{16{result_cur_i_i[15]}}, result_cur_i_i};
      REG_RESULT_CUR_Q: periph_rdata = {{16{result_cur_q_i[15]}}, result_cur_q_i};
      REG_AFE_CTRL:  periph_rdata = {16'd0, cfg_mux_settle_q, 2'd0,
                                     cfg_amplitude_q, cfg_tia_rf_q, 2'd0};
      REG_BOOT_STATUS: periph_rdata = boot_status_i;
      REG_SPI_CTRL:    periph_rdata = spi_ctrl_i;
      REG_SPI_DATA:    periph_rdata = {24'd0, spi_rx_i};
      REG_SPI_STATUS:  periph_rdata = spi_status_i;
      default:       periph_rdata = 32'd0;
    endcase
  end

  // --------------------------------------------------------------------------
  // Response: rvalid/err one cycle after every request, data muxed by the
  // registered decode so it lines up with the 1-cycle return.
  // --------------------------------------------------------------------------
  logic        rvalid_q;
  logic        err_q;
  logic        periph_rd_q;
  logic [31:0] periph_dout_q;

  always_ff @(posedge clk or negedge rst_n) begin
    if (!rst_n) begin
      rvalid_q      <= 1'b0;
      err_q         <= 1'b0;
      periph_rd_q   <= 1'b0;
      periph_dout_q <= 32'd0;
    end else begin
      rvalid_q    <= data_req_i;
      err_q       <= data_req_i && unmapped;
      periph_rd_q <= periph_rd;
      if (periph_rd) begin
        periph_dout_q <= periph_rdata;
      end
    end
  end

  assign data_rvalid_o = rvalid_q;
  assign data_err_o    = err_q;
  assign data_rdata_o  = periph_rd_q ? periph_dout_q : ram_dout;

endmodule
