krishkc5/agrasic/agriasic_digital_v2/tb/tb_agriasic_jtag.sv

// -----------------------------------------------------------------------------
// JTAG / RISC-V debug module testbench (Phase 2).
//
// Drives the chip's five JTAG pins with a behavioural IEEE 1149.1 master and
// speaks the RISC-V Debug Transport Module protocol (riscv-dbg dmi_jtag) to
// the Debug Module (dm_top), the way OpenOCD would. The real firmware runs
// underneath, so the halt lands inside a live measurement sweep.
//
// What is checked, in order:
//   1. TAP: IDCODE reads back the value programmed in the shell; DTMCS
//      reports abits=7 and DTM version 1 (Debug Spec 0.13).
//   2. DM: dmcontrol.dmactive; dmstatus.version=2, authenticated.
//   3. Halt: haltreq while the core is asleep in wfi (measurement in flight)
//      -> dmstatus.allhalted; Ibex's debug_mode observed.
//   4. Abstract commands: read dpc (inside the firmware image) and sp
//      (inside the relocated RAM) through data0 -- this exercises the debug
//      ROM / program buffer path on the INSTRUCTION side of the bus and
//      data0 on the DATA side.
//   5. System bus access: write/read RAM at 0x0001_0400, write/read the
//      last IMEM word (the loader path OpenOCD `load` uses), read an MMIO
//      register, and provoke sberror on an unmapped address.
//   6. Resume: resumereq -> allresumeack, and the firmware then completes the
//      sweep with correct results, read back BOTH through the hierarchy and
//      through the debugger's system bus.
//   7. ndmreset: core + peripheral bridge reset, DM survives, havereset
//      handshake acknowledged.
//   8. Boot control over the SBA (Phase 3): BOOT_CTRL.retry with no flash
//      attached -> boot FAIL (bad magic), boot_fail_o, core held and reported
//      unavailable; BOOT_CTRL.release -> core runs again. This is the bench
//      flow: load IMEM over JTAG, then release.
//
// TCK is a quarter of the core clock; each DMI transaction is followed by
// idle TCK cycles so the DTM's clock-domain crossing completes before the
// response is scanned out (a busy response is retried after dmireset, as
// OpenOCD does).
// -----------------------------------------------------------------------------
`timescale 1ns / 1ns

module tb_agriasic_jtag;

  localparam int unsigned ADC_WIDTH = 8;
  localparam int unsigned TCK_HALF  = 20;           // TCK = 40 ns, clk = 10 ns

  // Shell constants mirrored here (checked against the DUT where possible).
  localparam logic [31:0] EXP_IDCODE = 32'h1434_1001;
  localparam int unsigned NUM_FREQ_POINTS = 8;   // must match fw/fw.c
  // Scratch for the SBA write/read test. Deliberately NOT 0x100: that was
  // OUT_COUNT in the pre-relayout map and is still read as such further
  // down this file, so reusing it made the SBA probe and the result check
  // fight over one word. 0x120 is mid-guard -- 17 words above the end of
  // the result block (0x0DF) and 12 below the stack (0x150).
  localparam logic [31:0] SBA_SCRATCH = 32'h120;
  localparam logic [31:0] DMEM_BASE  = 32'h0001_0000;
  localparam logic [31:0] DM_BASE    = 32'h1A11_0000;

  // DTM instruction register
  localparam logic [4:0] IR_IDCODE = 5'h01;
  localparam logic [4:0] IR_DTMCS  = 5'h10;
  localparam logic [4:0] IR_DMI    = 5'h11;

  // DM registers (Debug Spec 0.13)
  localparam logic [6:0] DM_DATA0      = 7'h04;
  localparam logic [6:0] DM_DMCONTROL  = 7'h10;
  localparam logic [6:0] DM_DMSTATUS   = 7'h11;
  localparam logic [6:0] DM_ABSTRACTCS = 7'h16;
  localparam logic [6:0] DM_COMMAND    = 7'h17;
  localparam logic [6:0] DM_SBCS       = 7'h38;
  localparam logic [6:0] DM_SBADDRESS0 = 7'h39;
  localparam logic [6:0] DM_SBDATA0    = 7'h3C;

  localparam logic [31:0] DMCONTROL_DMACTIVE     = 32'h0000_0001;
  localparam logic [31:0] DMCONTROL_NDMRESET     = 32'h0000_0002;
  localparam logic [31:0] DMCONTROL_ACKHAVERESET = 32'h1000_0000;
  localparam logic [31:0] DMCONTROL_RESUMEREQ    = 32'h4000_0000;
  localparam logic [31:0] DMCONTROL_HALTREQ      = 32'h8000_0000;

  localparam logic [31:0] SBCS_SBACCESS32  = 32'h0004_0000;  // sbaccess = 2
  localparam logic [31:0] SBCS_SBREADONADDR = 32'h0010_0000;
  localparam logic [31:0] SBCS_SBERROR_MASK = 32'h0000_7000;
  localparam logic [31:0] SBCS_SBBUSY       = 32'h0020_0000;

  // ---------------------------------------------------------------------------
  // DUT and measurement-engine model (same as tb_agriasic_rv32i_e2e)
  // ---------------------------------------------------------------------------
  logic clk = 1'b0;
  logic rst_n;
  logic start_i;
  logic conv_start_o, busy_o, done_o;
  logic [ADC_WIDTH-1:0] sine_code_o;
  logic [1:0] mux_sel_o;
  logic adc_enable_o, adc_sample_o;
  logic [ADC_WIDTH-1:0] adc_dac_o;
  logic adc_comp_i;
  logic signed [15:0] result_dv_i_o, result_dv_q_o, result_cur_i_o, result_cur_q_o;
  logic [3:0]  cfg_pair_log2_o;
  logic [7:0]  cfg_settle_cycles_o;
  logic [13:0] cfg_exc_divider_o;
  logic [7:0]  cfg_conv_cycles_o;

  logic jtag_tck = 1'b0, jtag_tms = 1'b1, jtag_trst_n = 1'b0, jtag_tdi = 1'b0;
  logic jtag_tdo;

  always #5 clk = ~clk;

  // Rev 5 two-channel AFE model: dV (analog mux channel 0, PGA on E2/E3) and
  // return current (channel 1, TIA on E4). Both are frozen by the single
  // adc_sample_o strobe at the FSM's chosen phase point; the comparator then
  // answers for whichever channel mux_sel selects.
  logic [ADC_WIDTH-1:0] hold_dv_q, hold_cur_q;
  always_ff @(posedge clk) begin
    if (adc_sample_o) begin
      unique case (2'(dut.u_measurement_top.u_measurement_fsm.point_q))
        4'd0: begin hold_dv_q <= 8'd200; hold_cur_q <= 8'd170; end  // PT_0   (0 deg)
        4'd1: begin hold_dv_q <= 8'd100; hold_cur_q <= 8'd110; end  // PT_180 (180 deg)
        4'd2: begin hold_dv_q <= 8'd150; hold_cur_q <= 8'd140; end  // PT_90  (90 deg)
        4'd3: begin hold_dv_q <= 8'd80; hold_cur_q <= 8'd90; end  // PT_270 (270 deg)
        default: begin end
      endcase
    end
  end
  wire [ADC_WIDTH-1:0] adc_target = (mux_sel_o == 2'd0) ? hold_dv_q : hold_cur_q;
  assign adc_comp_i = (adc_target >= adc_dac_o);


  logic boot_fail;

  agriasic_digital_rv32i_top #(
    .ADC_WIDTH         (ADC_WIDTH),
    .BOOT_DELAY_CYCLES (64),
    .IMEM_PRELOADED    (1'b1)       // IMEM from $readmemh; boot strap low
  ) dut (
    .clk(clk), .rst_n(rst_n), .gpio_start_i(start_i),
    .afe_conv_start_o(conv_start_o), .afe_sine_code_o(sine_code_o), .afe_mux_sel_o(mux_sel_o),
    .afe_adc_enable_o(adc_enable_o), .afe_sample_o(adc_sample_o), .afe_adc_dac_o(adc_dac_o),
    .afe_adc_comp_i(adc_comp_i), .dbg_busy_o(busy_o), .dbg_done_o(done_o),
    .dbg_result_dv_i_o(result_dv_i_o), .dbg_result_dv_q_o(result_dv_q_o),
    .dbg_result_cur_i_o(result_cur_i_o), .dbg_result_cur_q_o(result_cur_q_o),
    .dbg_cfg_pair_log2_o(cfg_pair_log2_o), .dbg_cfg_settle_cycles_o(cfg_settle_cycles_o),
    .dbg_cfg_exc_divider_o(cfg_exc_divider_o), .dbg_cfg_conv_cycles_o(cfg_conv_cycles_o),
    .dbg_cfg_mux_settle_o(), .dbg_cfg_amplitude_o(), .afe_tia_rf_o(),
    .gpio_jtag_tck_i(jtag_tck), .gpio_jtag_tms_i(jtag_tms), .gpio_jtag_trst_ni(jtag_trst_n),
    .gpio_jtag_tdi_i(jtag_tdi), .gpio_jtag_tdo_o(jtag_tdo),
    .gpio_boot_sel_i(1'b0),
    .gpio_flash_sck_o(), .gpio_flash_cs_n_o(), .gpio_flash_mosi_o(), .gpio_flash_miso_i(1'b0),   // no flash on this bench
    .gpio_boot_fail_o(boot_fail)
  );

  wire fw_halted  = dut.u_control_shell.done_o;
  wire dbg_mode   = dut.u_control_shell.u_core.u_ibex_core.id_stage_i.controller_i.debug_mode_q;
  wire core_sleep = dut.u_control_shell.core_sleep;

  int errors = 0;
  int unsigned measurements_seen;
  always_ff @(posedge clk) begin
    if (!rst_n) measurements_seen <= 0;
    else if (done_o) measurements_seen <= measurements_seen + 1;
  end

  // ---------------------------------------------------------------------------
  // JTAG master
  // ---------------------------------------------------------------------------
  task automatic jtag_bit(input logic tms, input logic tdi, output logic tdo);
    jtag_tms = tms;
    jtag_tdi = tdi;
    #(TCK_HALF);
    tdo = jtag_tdo;          // TDO was launched on the previous falling edge
    jtag_tck = 1'b1;
    #(TCK_HALF);
    jtag_tck = 1'b0;
  endtask

  task automatic jtag_idle(input int n);
    logic d;
    repeat (n) jtag_bit(1'b0, 1'b0, d);
  endtask

  task automatic jtag_tap_reset();
    logic d;
    jtag_trst_n = 1'b0;
    #(4*TCK_HALF);
    jtag_trst_n = 1'b1;
    repeat (6) jtag_bit(1'b1, 1'b0, d);  // Test-Logic-Reset
    jtag_bit(1'b0, 1'b0, d);             // -> Run-Test/Idle
  endtask

  // From Run-Test/Idle, shift an IR value, return to Run-Test/Idle.
  task automatic jtag_shift_ir(input logic [4:0] ir);
    logic d;
    jtag_bit(1'b1, 1'b0, d);   // Select-DR
    jtag_bit(1'b1, 1'b0, d);   // Select-IR
    jtag_bit(1'b0, 1'b0, d);   // Capture-IR
    jtag_bit(1'b0, 1'b0, d);   // Shift-IR
    for (int i = 0; i < 5; i++) jtag_bit((i == 4), ir[i], d);  // last bit -> Exit1-IR
    jtag_bit(1'b1, 1'b0, d);   // Update-IR
    jtag_bit(1'b0, 1'b0, d);   // Run-Test/Idle
  endtask

  // From Run-Test/Idle, shift n bits through DR (LSB first), return to RTI.
  task automatic jtag_shift_dr(input int n, input logic [63:0] din, output logic [63:0] dout);
    logic d;
    dout = '0;
    jtag_bit(1'b1, 1'b0, d);   // Select-DR
    jtag_bit(1'b0, 1'b0, d);   // Capture-DR
    jtag_bit(1'b0, 1'b0, d);   // Shift-DR
    for (int i = 0; i < n; i++) begin
      jtag_bit((i == n-1), din[i], d);
      dout[i] = d;
    end
    jtag_bit(1'b1, 1'b0, d);   // Update-DR
    jtag_bit(1'b0, 1'b0, d);   // Run-Test/Idle
  endtask

  // ---------------------------------------------------------------------------
  // DTM / DMI layer
  // ---------------------------------------------------------------------------
  task automatic dtmcs_dmireset();
    logic [63:0] r;
    jtag_shift_ir(IR_DTMCS);
    jtag_shift_dr(32, 64'h0001_0000, r);   // dmireset
    jtag_shift_ir(IR_DMI);
  endtask
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
