krishkc5/agrasic/(commit log)

2026-09-02 Add AgriASIC digital subsystem with RV32I control layer
    Digital control subsystem for the AgriASIC impedance sensing node, using a
    two-layer partition: an RV32IM core as the programming/policy layer above the
    existing measurement FSM, which remains the real-time timing engine for
    excitation, settle, sample and accumulation.
    Processor (adapted from CIS 5710 hw5):
    - 5-stage pipelined RV32IM datapath, CLA adder (hw2b), pipelined divider (hw4)
    - Retargeted from FPGA-style memory to synchronous SRAM:
    instruction SRAM output register now serves as the fetch/decode pipeline
    register; load byte-extraction moved from Memory to Writeback; M->X load
    forwarding removed; load-use stall widened to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
2026-09-02 Add repository README and refresh digital subsystem README
    The repo root had no README, so the GitHub landing page showed only a folder.
    Adds one covering the two-layer control partition (software sets policy, the
    measurement FSM keeps time), a reading order for newcomers, toolchain setup,
    build and verification commands, current status, and known open items.
    Also refreshes agriasic_digital_v2/README.md, which still described the
    pre-RV32I skeleton: its bring-up order predated rtl/rv32i/, fw/ and the
    regression suite. Now documents the processor's CIS 5710 provenance and the
    synchronous-SRAM retarget, the data-side memory map, and the Harvard-split
    constraint that firmware must respect.
2026-09-05 Rev 4.3 Phases 1-4: analog boundary, clock/reset discipline, SPI rework, phase-locked excitation
    Implements and verifies the Rev 4.3 restructure against
    agriasic_rev43_phase_locked_design.pdf:
    - Phase 1: break-before-make excitation drive (exc_drive_p_o/n_o, 2'b11
    structurally unreachable), real SAR bit-trial engine (adc_dac_o/adc_comp_i,
    adc_code_i removed), miso_oe_o for MISO high-Z.
    - Phase 2: 2FF reset synchronizer per chip-boundary top; RV32I core clock
    enable (not gated), verified idle 93% of cycles during a real measurement.
    - Phase 3: SPI moved entirely into the clk domain (2FF-oversampled
    sclk/cs_n/mosi), zero remaining always_ff outside posedge clk.
    - Phase 4: excitation_c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
2026-09-08 Bring remaining diagrams and MAS naming in line with Rev 4.3
    The Rev 4.3 commits updated the MAS, the interface contract and 12 diagrams, but
    seven diagrams were never touched and still described the pre-Rev-4.3 design.
    Six of those are now corrected; regfile_block_diagram is untouched because
    regfile.sv itself has not changed.
    Redrawn:
    - modules/agriasic_digital_top_block_diagram: showed adc_code_i, exc_pol_o,
    result_o, exc_set_phase and (D+ - D-)/2. Now shows the free-running excitation
    exporting phase_index and period_tick, the adc_dac/adc_comp bit-trial
    interface, and separate I and Q results.
    - agriasic_measurement_fsm_cycle_flow: showed the 8-state SETTLE_P / SAMPLE_D /
    ACCUM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
2026-09-11 system flow PUML
2026-09-21 memory flowchart
2026-10-16 Timing setup, ADC overrange, gain decode, and open-item cleanup
    Timing (new timing/ directory)
    - agriasic_digital_rv32i_top.sdc: full constraints. Flags the three that are
    easy to get wrong and hide a real failure: gpio_spi_sclk_i is NOT a clock
    (it is oversampled), afe_adc_comp_i is NOT a false path (deliberately
    unsynchronised and timed by conv_cycles), and the rst_n release IS timed.
    - path_depth.py: structural longest-path analysis over the yosys netlist.
    Signoff STA needs a Liberty library the project does not have; this
    identifies which paths to look at first.
    - Finding: the IMEM read path ranks #1 outside the core, confirming that a
    256:1 mux now sits in the fetch path wit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
2026-10-16 Latch-based IMEM and DMEM, now the default storage
    With no SRAM compiler, the memories are standard-cell arrays and the cell
    choice is worth real die area. Latches replace flops as the default;
    AGRIASIC_FLOP_MEM selects the flop array back.
    Measured, not estimated:
    Registers Latches Comb. Gate-equiv
    Flop array 16,299 -- 44,078 181 kGE
    Latch array (now) 4,083 12,675 44,783 153 kGE
    28 kGE, roughly 0.24-0.41 mm^2 placed. Against the 5 mm^2 die budget that is
    ~4.8-6.2 mm^2 down to ~4.5-5.7 mm^2.
    What does NOT improve, which is the more useful number: latches cut the
    storage from 74 kGE to 44 kGE, but the read mux stays at 28 k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
2026-10-18 Concise design reference, Rev 5 sequence diagram, system overview
    docs/agriasic_digital_design_reference.md -- the current design, module by
    module, in ~290 lines against the MAS's ~3,070. The MAS stays as the living
    record of superseded decisions and reasoning; this is what to hand someone who
    needs to know what the design IS. Cross-linked from both the MAS and the README.
    Covers: what the chip measures, the address map and pad list, every instantiated
    module with its diagram, the software interface, and where things stand on area,
    verification and open items with owners.
    Sequence diagram rewritten for Rev 5 + Ibex. The old one described the
    single-channel Rev 4.3 flow: d_plus/d_minus, on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
2026-10-18 Remove programmable gain from the voltage-sense channel
    Analog review concluded the differential PGA does not need programmable gain,
    and the measurement physics agrees: in a voltage-driven tetrapolar setup
    dV = V_drive x (R23/R_total), and both resistances scale with soil resistivity,
    so the ratio is set by electrode geometry rather than conductivity. The voltage
    channel has little dynamic range. The current channel carries it
    (I = V_drive/R_total, 3-4 decades across the soil range), so the TIA keeps its
    programmable Rf and its three switch wires.
    Removed afe_pga_gain_o from the MMIO bridge, control shell and chip top.
    AFE_CTRL[1:0] is retired with the wires rather than left inert -- a reg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
2026-10-19 digital: real abort, start rejection, and move the engine to sys_rst_n
    Restarting a measurement had three problems, each of which could present a
    stale result as a fresh one.
    1. The sequencer only samples start in S_IDLE, so a CTRL.START arriving
    mid-run did nothing and left no trace -- firmware could not tell
    "restarted" from "ignored". Such a write is now rejected explicitly and
    sets the sticky STATUS[7] start-rejected flag, cleared by CTRL.clear_err.
    2. There was no way to cut a run short. CTRL bit 1 is now a real abort: it
    forces measurement_fsm and sar_controller back to S_IDLE and clears busy,
    while emitting no done pulse and no interrupt, so an aborted run can never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
2026-10-19 digital: abort wakes the core; pre-freeze review of the handoff contracts
    Part 1 -- an abort must wake the core, without claiming a result.
    Abort emitted no done pulse and the wfi wake source was done alone, so a host
    abort rescued the engine and stranded the processor: firmware slept forever
    with the sweep half finished. Making abort set done would have been wrong --
    done means "a fresh result is in the shadow registers", and an abort never
    reaches the S_LOOP -> S_DONE transition that writes them, so
    run_one_measurement() would have woken, passed its busy guard and averaged the
    PREVIOUS point's I/Q into the current one: the same stale-result bug, moved out
    of the bridge and into the firmwa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
2026-10-24 imem: fill the whole array before $readmemh, not only when there is no image
    The NOP fill sat in an `else`, so with an INIT_FILE every word past the
    firmware image stayed uninitialised. The image is 136 words in a 256-word
    array, and the boot copier writes only ROM_USED_WORDS, so words 136..255 were
    never written by any path: X in a 4-state simulator, 0 under Verilator. That
    is why 16/16 stages passed here while the server run showed X.
    This is not cosmetic X-cleanliness. Instrumenting the e2e fetch bus shows the
    core makes exactly two speculative fetches past main's `ret` at 0x21c -- 0x220
    and 0x224, bounded by NUM_REQS=2 / FIFO DEPTH=3 -- and both are discarded by
    the branch flush. But ib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
2026-10-25 verify: gate every regression stage; deepen the no-preload boot test
    Three changes, all in verification except one RTL comment.
    1. verify_all.sh gates each stage three ways instead of not at all: the stage
    must produce output, must exit 0, and must print its expected PASS token.
    The lint stages key off the "=== ... lint done ===" markers they already
    emit, plus "no ^%Error". Exit status is non-zero if any gate fails, and the
    summary names the failures.
    The old sweep piped each stage straight into `grep | tail`, so the exit
    status was grep's and a stage that died contributed no output, no FAIL
    token, and nothing for a reader to notice. That is how a run yesterday
    rep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
2026-10-25 dmem: relay the result map for an 8-point sweep, and sweep 8 frequencies
    Two coupled changes. They are NOT split into separate commits because they
    could not be verified separately: the 8-point map does not fit the old layout,
    and the testbench collisions below were only found once both were in place.
    A layout-only commit would be one I never saw green.
    RESULT MAP AND DMEM SIZE
    DMEM 128 -> 96 words (384 B). Only 44 of 128 words were ever used: words
    0..63 unused, results at 64..95, stack at 116..127. The result block now
    starts at offset 0 with each array a full 8 words (0x20) wide:
    0x000 COUNT / 0x004 NUM_POINTS / 0x008 TEMP / 0x00C reserved (5 words)
    0x020 DIV[8] 0x040 DV_I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
2026-10-25 docs: re-scope the sweep, the result map and the DMEM size; GAP-11 is resolved
    The docs described a 3-point sweep storing results at 0x100, in a 512 B DMEM,
    with no host path off chip. All four claims are now wrong, and the last one is
    the dangerous kind: it told host authors not to expect results they can in
    fact read.
    interface_contract.md
    - GAP-11 was marked "not yet resolved: sweep results have no host-facing
    path out of the chip at all". That predated the host SPI port. Results are
    readable two ways and both are in the regression: stage 15 reads
    OUT_COUNT/OUT_NUM_POINTS and per-point results over SPI (M4), stage 13
    does the same over the debug SBA. Replaced with the r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
2026-10-25 docs: the module details the sweep and the host SPI port left behind
    Audited every AgriASIC-authored module's parameters and ports against what
    the docs, the diagrams and the RTL headers claim. Four real mismatches, all
    of them things a reader would have acted on:
    - The interconnect gained M4 (host SPI) but was still documented as a
    4-master bus in five places in the MAS, in its own RTL header ("Three
    OBI-style masters"), in the block diagram -- which drew only M0..M3, so
    the host port was invisible -- and in the control-shell and system-overview
    diagrams. The 6.15 permissions table had no M4 row, so the one place that
    says permissions are "enforced in the decode, not just documen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
2026-10-27 surfer: signal lists for the e2e and measurement views, and a launcher
    e2e_overview.surfer follows a full run from boot through the sweep, wake
    and park (72 signals, ten sections); measurement_detail.surfer is the
    engine alone on smoke.fst (32 signals). open_waves.ps1 opens either view
    on its trace from any directory: .\tb\surfer\open_waves.ps1 e2e|detail.
2026-10-27 verify: opt-in WAVES=1 FST dumping for every regression stage
    waves.sh generates a wave_dump module and binds it into whichever
    testbench top a stage names, so no testbench changed; each stage script
    gains the same source / wave_setup / $WAVE_ARGS / wave_report hook. Off
    by default, so verify_all.sh is unaffected. WAVE_FORMAT, WAVE_START,
    WAVE_DEPTH and WAVE_DIR are optional; the README documents them and the
    two Verilator limits ($dumpvars scope/level and $dumpoff/$dumpon are
    ignored) that shaped them.
2026-10-27 sar: pulse conv_start_o when the mux settles, not at acceptance
    conv_start_o now fires as the mux_settle wait expires, immediately
    before the first bit trial, so it marks the instant the converter starts
    on a settled input -- the event the analog behavioural model's start
    input consumes. Still one cycle, still exactly one per accepted request;
    only its position moved. The header also corrects the conversion time to
    8 * (3 + conv_cycles_i) cycles (SET, WAIT, EVAL per trial).
    The MAS and the interface contract drop the old "carries no information"
    description of conv_start_o. The contract also notes that afe_tia_rf_o
    exists only on the RV32I top, since the SPI and programming register
    maps ha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
2026-10-29 spi-host: the host polls STATUS[6] for completion, against a derived bound
    Scenario E used to wait on dut.u_control_shell.done_o, a hierarchical
    probe no host has, which gated the whole result readout on a signal
    silicon cannot see. It now polls STATUS[6] (fw_done) over SPI with a
    0x03 read truncated after one data byte: little-endian-within-word puts
    STATUS[7:0] first, and dropping CS_N early commits nothing on a read,
    so six bytes replace nine. That every later transaction still works is
    itself the proof the truncation leaves the bridge clean. The probe
    stays, demoted to a cross-check that the bridge never reports a
    completion the firmware did not signal. Scenario H is gated on the same
    ho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
2026-10-31 pre-freeze: reset abort_pulse_o, refresh area figures, fence off the stale memory doc
    abort_pulse_o was missing from the MMIO reset branch, so slang could not
    infer its asynchronous reset and generic synthesis reported a warning
    where the recorded log had none. Benign in silicon -- the engine shares
    shell_sys_rst_n with the bridge, so both leave reset together with the
    FSM idle, and abort-while-idle is a no-op -- but it was the only thing
    between this build and a clean log, and a reviewer cannot tell a benign
    warning from a real one without chasing it. Synthesis is back to
    0 errors, 0 warnings; verify_all is 16/16.
    Section 6.16's area table was measured before the DMEM 128 -> 96
    relayout an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
2026-11-02 timing: re-measure path depth on the latch default, correct the flop-array docs
    The findings in timing/README.md were measured 2026-10-15 from a netlist built
    one day before latches became the default storage (18ad99f), so the whole
    section described the flop build while claiming to describe the design. The
    stale wording in three places was the visible symptom; the numbers were the
    actual problem, and path_depth.py does not set AGRIASIC_FLOP_MEM, so re-running
    it today silently produced different results.
    Re-measured 2026-11-02 on the current RTL (69,233 cells, memories included,
    abc enabled):
    Ibex fetch address datapath 125 -> 128 levels
    IMEM read path 111 -> 115 leve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
2026-11-03 flash-boot: scenario D must see the core run, not just core_sleep high
    D's "core reaches its first wfi" check passed without the core ever
    leaving reset. Ibex reports core_sleep while it is held, so core_sleep was
    already high at D's DONE and the wait returned on cycle 0; E's chip reset
    then landed one cycle later. In the trace, core_rst_n stayed low from A's
    end through D.
    Wait for core_rst_n, then for core_sleep to drop, then for the first wfi.
    D now releases the core and reaches wfi 78 cycles after boot, the same as
    A and E. FLASH_BOOT_PASS.
2026-11-03 tb: one-reset power-up end-to-end demo for both boot sources
    tb_agriasic_boot_e2e boots for real from a single reset release: IMEM
    starts empty, the boot FSM fills it from the golden ROM (BOOT_FROM_FLASH=0)
    or from a behavioural SPI NOR (=1), the core is released, and the firmware
    runs the 8-point sweep to FW_DONE and parks. It checks that nothing is
    fetched before fw_valid, the flash pins (idle for ROM, driven then released
    for flash), every IMEM write's address and word, IMEM against the image,
    the same DMEM results as tb_agriasic_rv32i_e2e, and wfi sleep. The e2e bench
    preloads IMEM and never boots; flash_boot covers it but across seven
    scenarios and five resets.
    boot_rom_e2e.sh ROM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
2026-11-09 sdc: time flash MISO from the SCK falling edge as an 8-cycle multicycle
    The flash runs SPI mode 0 and changes MISO after SCK falls; agriasic_spi_boot
    samples it on the clk edge that raises SCK again, (eng_div+1) = 8 clk cycles
    later at the clk/16 boot rate. The SDC referenced the input delay to the
    rising edge with no multicycle, so STA timed MISO into the very next clk
    edge and the placeholder 10 ns t_V could never fit one 6.25 ns period
    (view_tc setup WNS -3.718 at u_boot_sh_rx_q_reg[0]).
    Input delay is now -clock_fall with setup -end 8 / hold -end 7. If firmware
    picks a faster divider, the multicycle has to follow the fastest one used.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
2026-11-10 rtl/tech: TSMC 180 prim_clock_gating on the CKLNQD integrated clock gate
    The ASIC build used ibex/prim_generic/prim_clock_gating.sv, which Genus
    builds as a separate latch (LHQD/LNQD) and NAND/AND. Tempus then infers
    clock-gating checks between the two, with the full 0.25 ns uncertainty and
    the useful-skew cells CCOpt puts on the gate's clock pin. On the latch
    memories' lane gates that left ~600 setup (view_wc, WNS -0.141) and ~1,380
    hold (view_bc, WNS -0.219) violators, and hold fixing on the latch -> AND
    net is what pushed the setup ones over.
    rtl/tech/tsmc180/prim_clock_gating.sv has the same name, parameters and
    ports and instantiates CKLNQD1BWP7T (clock_gating_integrated_cell :
    latch_p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
2026-11-11 asic_top: chip-level wrapper with a behavioural AFE macro and template .lib
    rtl/agriasic_asic_top.sv joins agriasic_digital_rv32i_top (unchanged, still
    the digital synthesis target) to the analog front end, agriasic_afe_top, and
    makes the eight AFE contract signals die-internal nets. No pad ring yet.
    rtl/analog/ behavioural view of the AFE macro, simulation only
    (AGRIASIC_AFE_BEHAVIORAL selects real-valued ports)
    lib/agriasic_afe_top.lib template Liberty so STA/P&R can link the macro
    before the analog team delivers; every number is a
    placeholder, the pin list is the contract
    tb/tb_agriasic_asic_top.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
2026-11-12 sdc: leave 1.7 ns of each cycle to the AFE side instead of 2.0
    Every set_output_delay on the AFE outputs drops from 2.0 to 1.7 ns. With
    2.0, the 11-11 implementation failed only on afe_sine_code_o (view_wc,
    worst -0.291 ns, 6 bits): the code is combinational from the measurement
    FSM, launched behind 1.73 ns of clock tree, and arrives at 4.291 ns
    against 6.25 - 2.0 - 0.25 = 4.00 ns. At 1.7 the requirement is 4.30 ns,
    so the current implementation meets it with 9 ps to spare. No other AFE
    input or output was failing.
    The value is still a placeholder until analog characterises its inputs
    (GAP-2). asic-top's chip_afe.sdc AFE_IN_BUDGET moves to 1.7 with it.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
2026-11-12 tb: build the SAR bit-trial stage with --assert
    sar_bit_trial.sh was the one stage compiled without --assert, so its
    p_sample_single_cycle property never ran: Verilator drops every assertion
    without the flag. Every other simulation stage already passes it.
2026-11-12 sar_controller: drive adc_dac_o from a register
    adc_dac_o was decoded from state_q: (state_q == S_IDLE) ? dac_reg_q :
    dac_reg_q | trial_mask. The state is binary-encoded in the netlist (three
    flops), and the S_TRIAL_WAIT -> S_TRIAL_EVAL step is 3'b011 -> 3'b100, so
    the S_IDLE decode can glitch and briefly drop the bit under test at the
    start of EVAL, the last cycle before the comparator decision is sampled.
    adc_dac_o is now a flop, loaded wherever dac_reg_q / bit_idx_q / state_q
    are, with the code those are about to produce: MSB mask at acceptance,
    eval_code | (trial_mask >> 1) for the next trial, the converged code at
    the last EVAL, dac_reg_q on abort. It shows each code in the same cycle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
2026-11-12 tb: build the excitation stage with --assert
    excitation_drive.sh compiled without --assert, so Verilator dropped
    excitation_ctrl's assertions in the stage that unit-tests it. b388c88 said
    sar_bit_trial.sh was the last stage without the flag. It was not: seven
    more (smoke, spi_smoke, rst_sync_check, spi_domain_crossing, settle_check,
    accum_edge_cases, settle_conv_sweep) still build without it.
2026-11-12 tb: start the smoke mux-stability check one cycle after acceptance
    p_mux_stable_during_conversion tested the live sar_controller state_q. The
    controller drives mux_sel_o from channel_i and moves state_q to S_MUX_WAIT
    on the same edge when it accepts a conversion, so at the next edge the
    antecedent was already true while $stable still saw the acceptance's mux
    change. Every channel switch tripped it ("MUX_FAIL: afe_mux_sel_o changed
    during a conversion", first at 915000 on the dV -> current switch).
    The antecedent is now $past(state_q) != 0 (S_IDLE). mux_sel_o is assigned only
    at reset and at acceptance, so this drops the acceptance edge alone and
    still checks the settle wait and every bit tr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
2026-11-12 tb: build the remaining seven simulation stages with --assert
    smoke, spi_smoke, rst_sync_check, spi_domain_crossing, settle_check,
    accum_edge_cases and settle_conv_sweep built without --assert, so Verilator
    dropped every RTL and testbench assertion in them. With this, every
    simulation stage of verify_all.sh builds with --assert, completing
    b388c88 and 267e3be.
    Verified: verify_all.sh 18/18.
